DangerousPrototypes/Bus_Blaster/art/BusBlasterv3c600.jpg

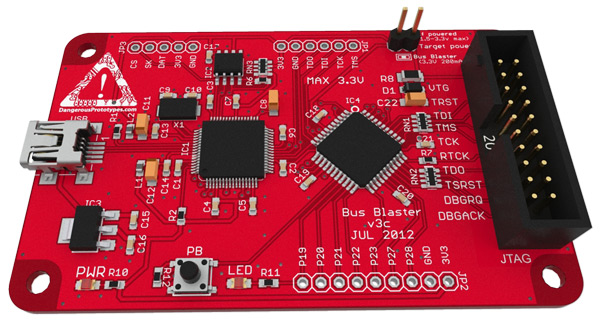
art/BusBlasterv3c600.jpg
