DangerousPrototypes/Bus_Blaster/art/bus-blaster-FTDI.jpg

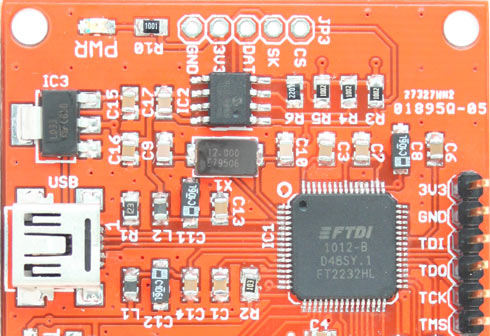
art/bus-blaster-FTDI.jpg
