DangerousPrototypes/Bus_Blaster/manufacturing_resources/v4.1/Test/testplan.txt

http://dangerousprototypes.com/docs/Bus_Blaster_v4_manufacturing_resources
