DangerousPrototypes/Bus_Blaster/hardware/BusBlaster-v2.5.htm

Part | Quantity | Value | Package
C1-C7,C13-C21 | 16 | 100nF | C603
C8 | 1 | 3.3uF | SMC_A
C9,C10 | 2 | 27pF | C603
C11,C12,C22 | 3 | 4.7uF | SMC_A
IC1 | 1 | FT2232H | LQFP64
IC2 | 1 | 93LC46B | SOIC8
IC3 | 1 | LD1117-3.3 | SOT223
IC4 | 1 | XC2C32A_VQ44_2 | VQ44
JP4 | 1 | 0.1” pin header | 1X02
JTAG | 1 | 2x10 shrouded header (0.1”) | PINHEAD_-_COPY_PINSHRD_PTH_2X10
L1,L2 | 2 | ferrite bead (800mA+) | FB603
LED | 1 | LED | LED-805
PB | 1 | Small push button | TACT_SWITCH_SMALL
PWR | 1 | LED | CHIPLED_0805
R1 | 1 | 12K 1% | R603
R2,R11 | 2 | 1K | R603
R3,R4,R5 | 4 | 10K | R603
R6 | 1 | 2.2K | R603
R10 | 1 | 1K | R603
USB | 1 | USB mini-B connector | CONN_USB_MINI-B
X1 | 1 | 12MHz crystal | 4X6@1
