DangerousPrototypes/Bus_Blaster/art/bb-v2-buffer.png

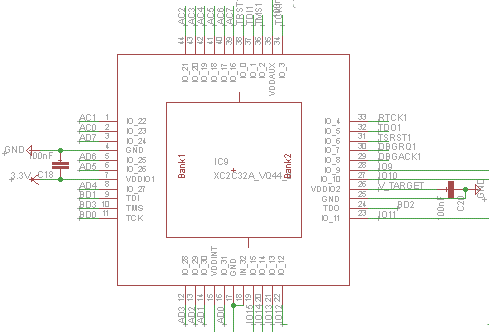
art/bb-v2-buffer.png
