DangerousPrototypes/Bus_Blaster/art/bus-blaster-buffer.jpg

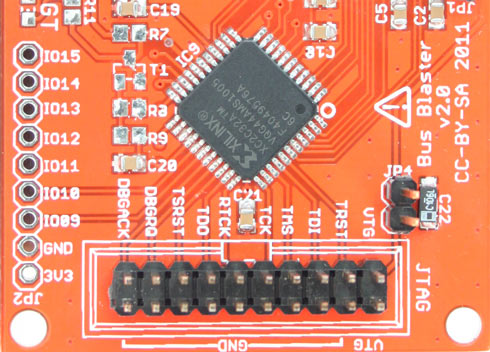
art/bus-blaster-buffer.jpg
