DangerousPrototypes/Bus_Blaster/art/bus-blaster-cover-shot-2-25.jpg

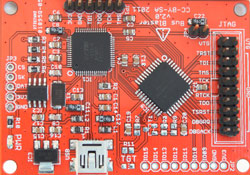
art/bus-blaster-cover-shot-2-25.jpg
