DangerousPrototypes/Bus_Blaster/art/bus-blaster-cover-shot.jpg

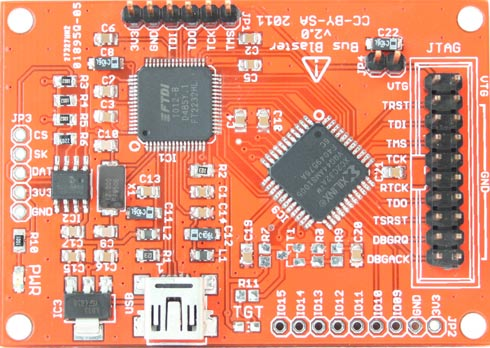
art/bus-blaster-cover-shot.jpg
