DangerousPrototypes/Bus_Blaster/art/bus-blaster-v2-block-diagra.png

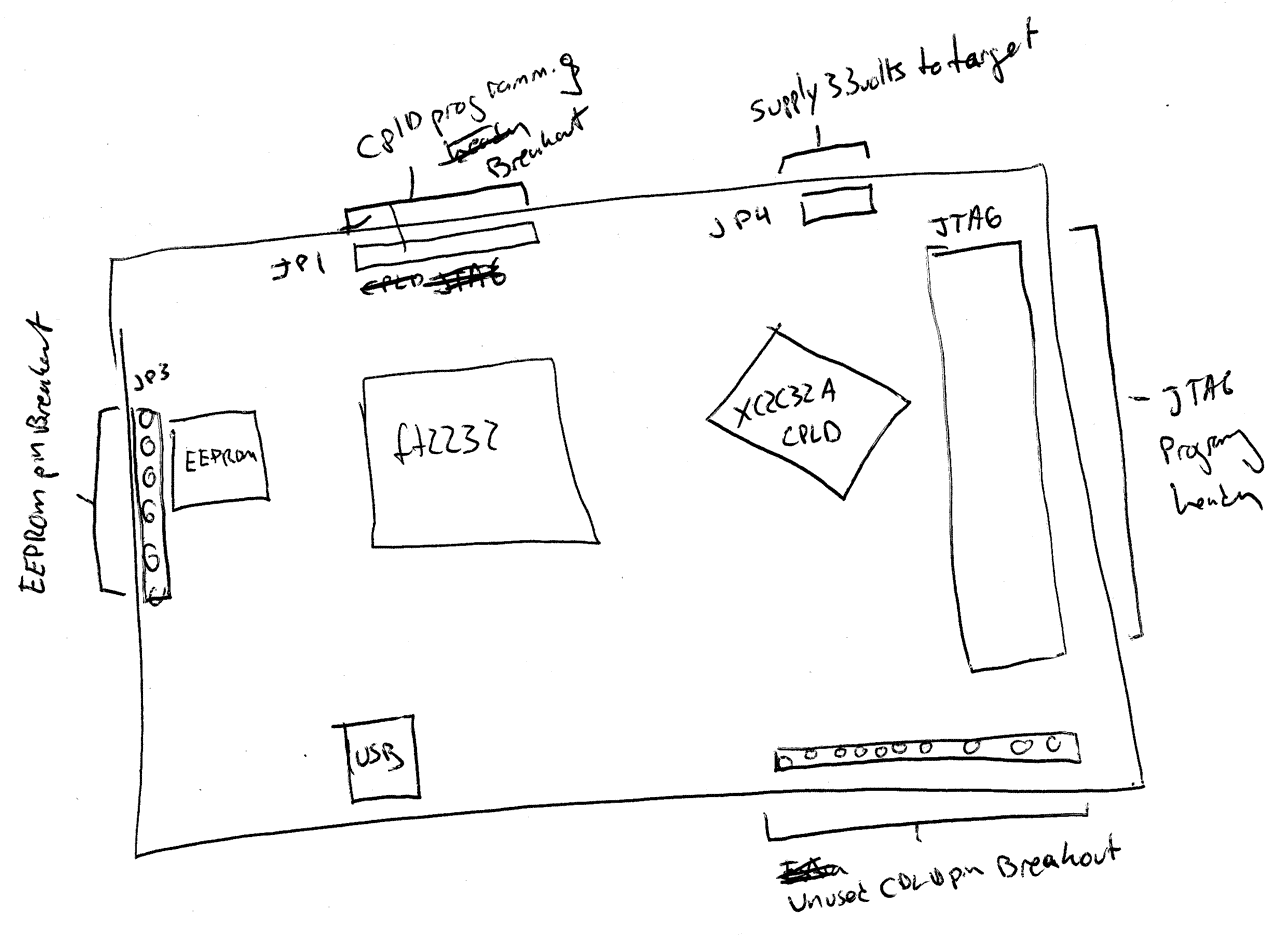
art/bus-blaster-v2-block-diagra.png
