DangerousPrototypes/Bus_Blaster/art/bus-blaster-v2-pcb.jpg

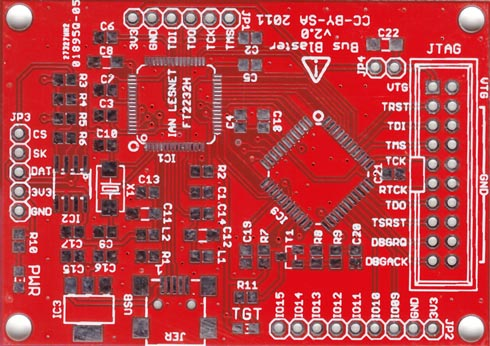
art/bus-blaster-v2-pcb.jpg
