DangerousPrototypes/Bus_Blaster/art/bus-blaster-v2-pinout.png

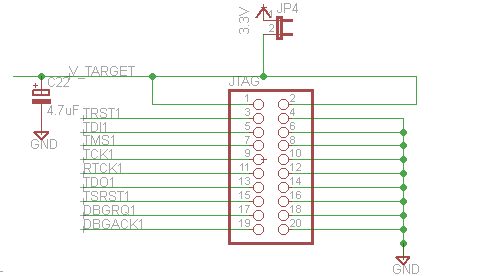
art/bus-blaster-v2-pinout.png
