DangerousPrototypes/Bus_Blaster/art/bus-blaster-v2.1-dev-update.jpg

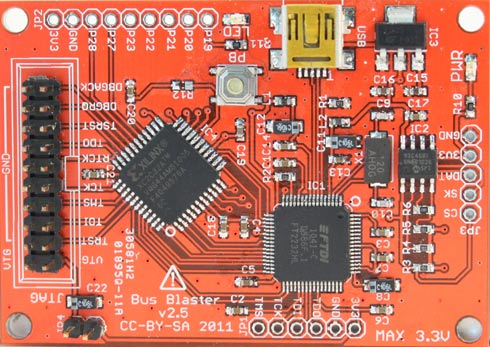
art/bus-blaster-v2.1-dev-update.jpg
