DangerousPrototypes/Bus_Blaster/art/BusBlaster3a.jpg

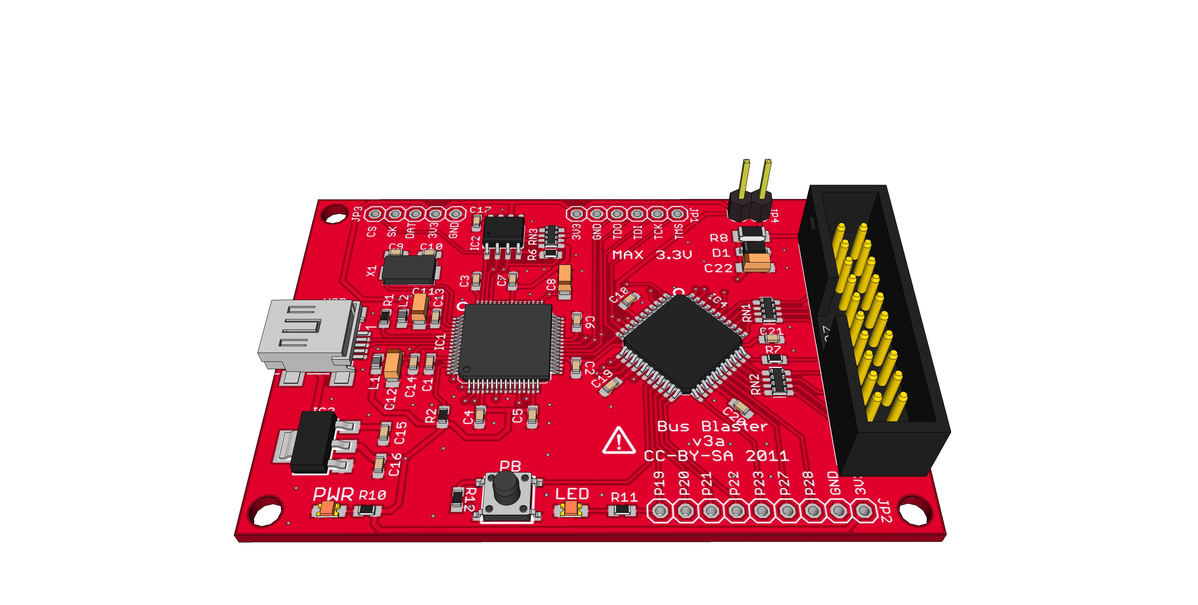
art/BusBlaster3a.jpg
