DangerousPrototypes/Bus_Blaster/art/Busblasterv2-490px.png

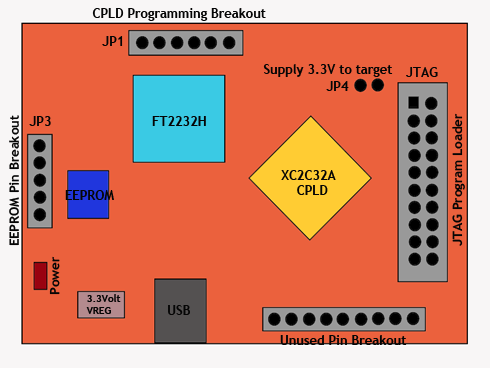
art/Busblasterv2-490px.png
