DangerousPrototypes/Bus_Blaster/art/Busblasterv2.png

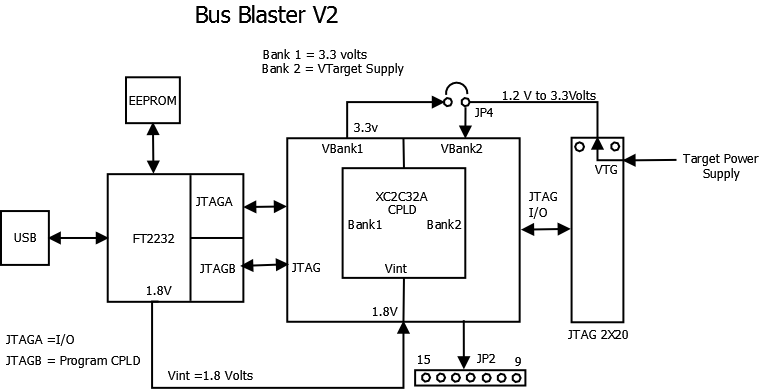
art/Busblasterv2.png
