DangerousPrototypes/Bus_Blaster/art/BusBlasterv2a1.png

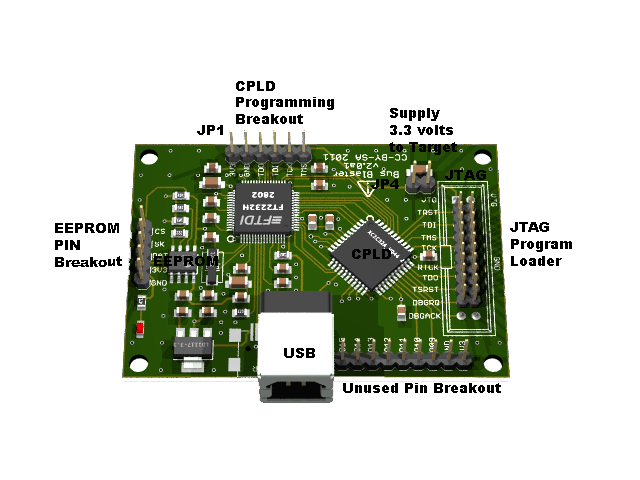
art/BusBlasterv2a1.png
