DangerousPrototypes/Bus_Blaster/art/BusBlasterv3c-orig.tif

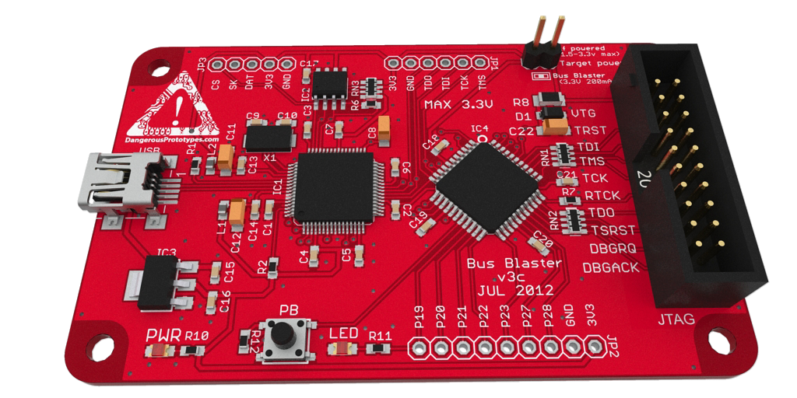
art/BusBlasterv3c-orig.tif
