DangerousPrototypes/Bus_Blaster/hardware/BusBlaster-v2.1a.brd.png

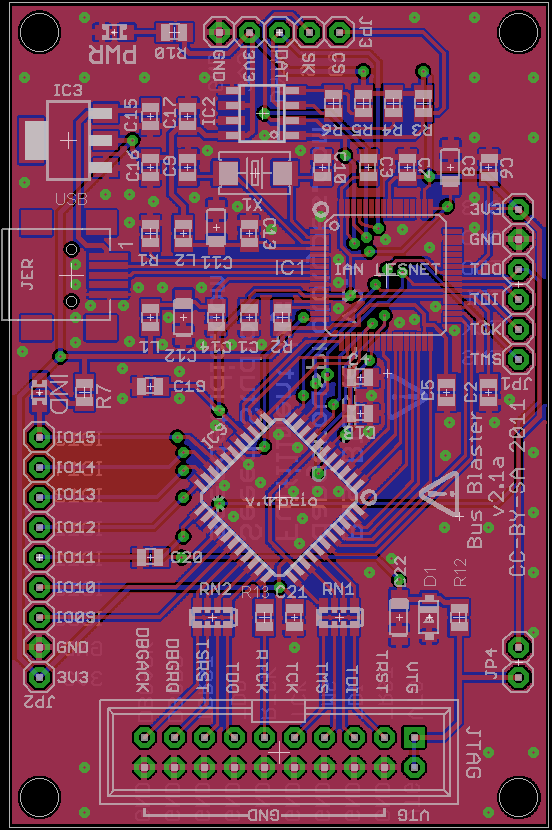
hardware/BusBlaster-v2.1a.brd.png
