DangerousPrototypes/Bus_Blaster/hardware/BusBlaster-v2.1a.sch.png

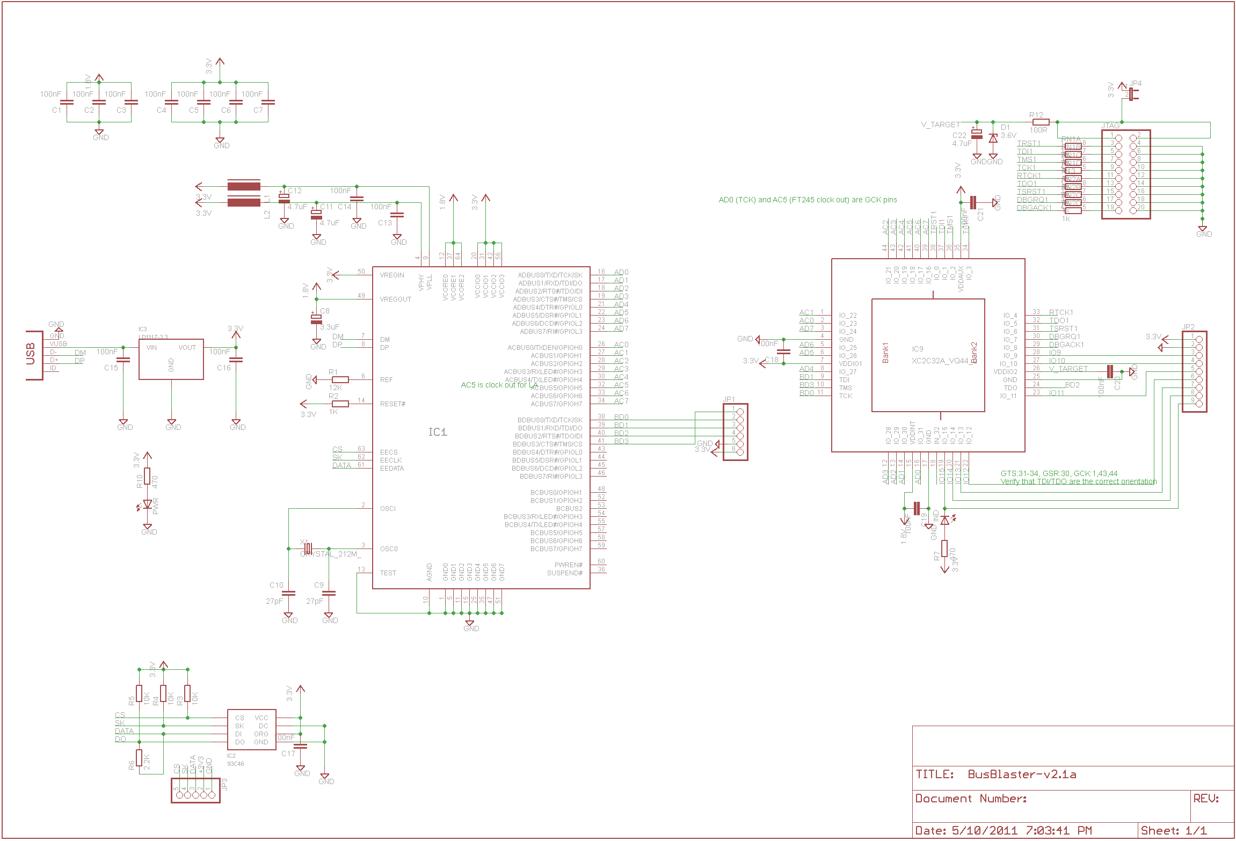
hardware/BusBlaster-v2.1a.sch.png
