DangerousPrototypes/Bus_Blaster/hardware/BusBlaster-v2.5.sch.png

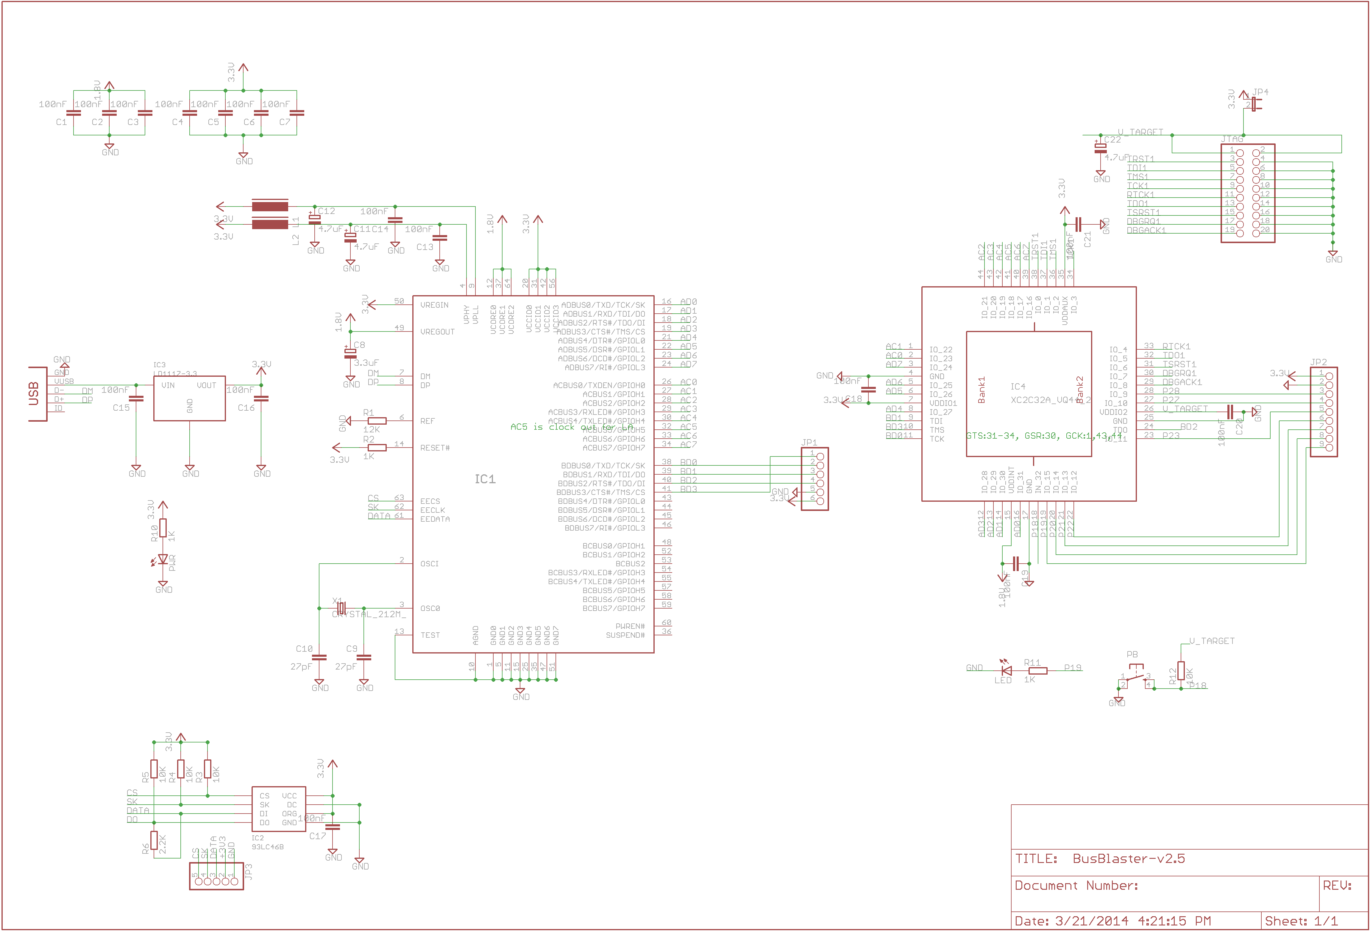
hardware/BusBlaster-v2.5.sch.png
