DangerousPrototypes/Bus_Blaster/hardware/BusBlaster-v2.6.brd.png

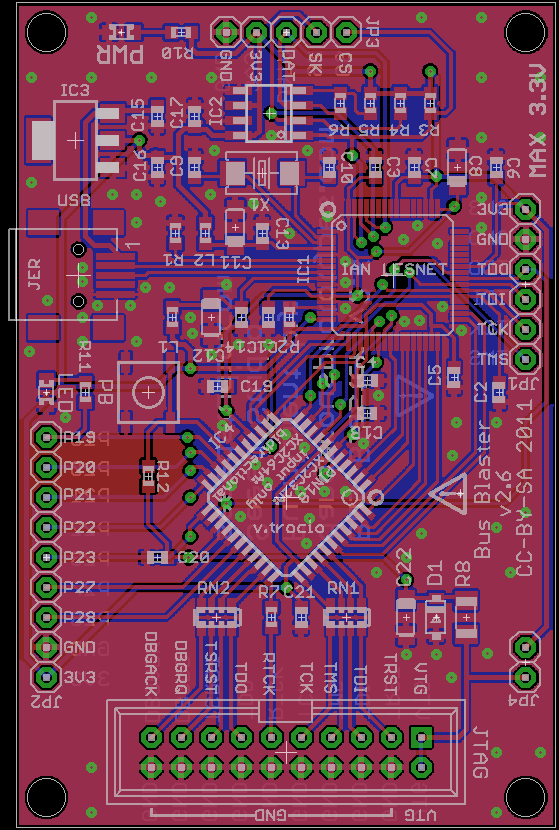
hardware/BusBlaster-v2.6.brd.png
