DangerousPrototypes/Bus_Blaster/hardware/BusBlaster-v3c.brd.png

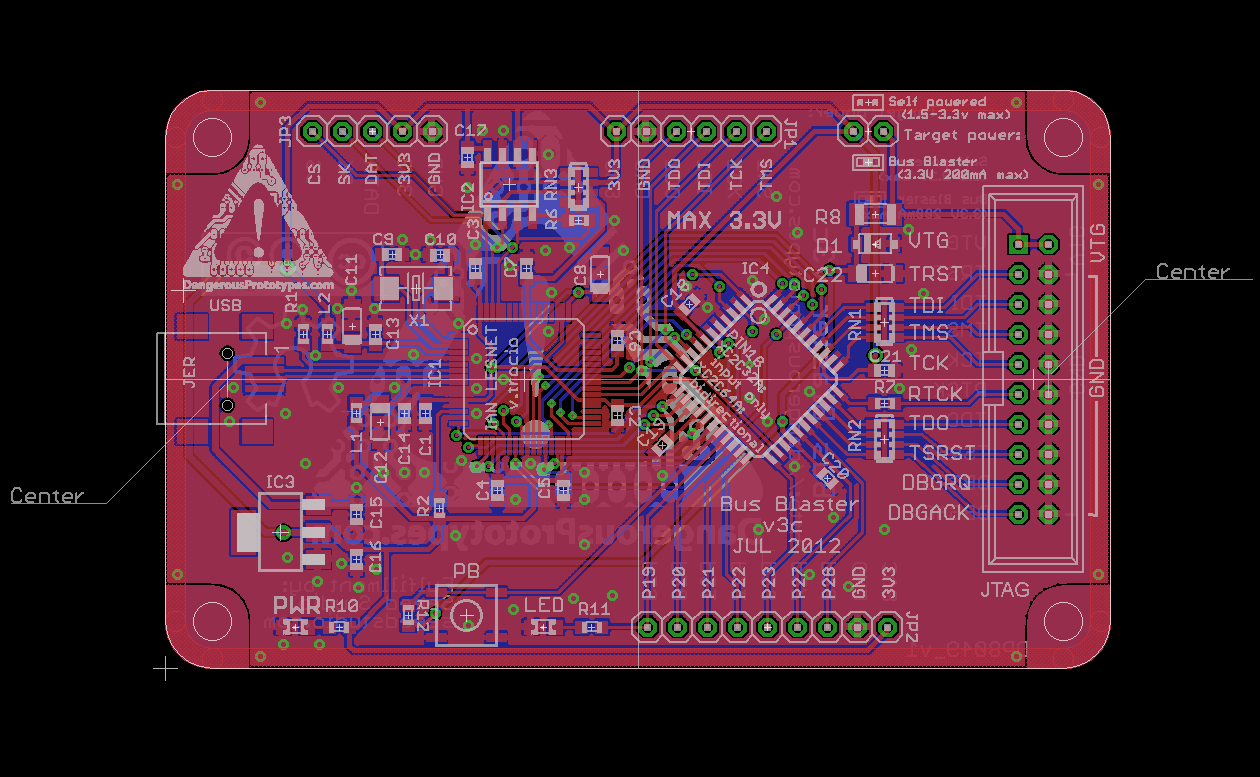
hardware/BusBlaster-v3c.brd.png
