DangerousPrototypes/Bus_Blaster/hardware/BusBlaster-v3c.sch.png

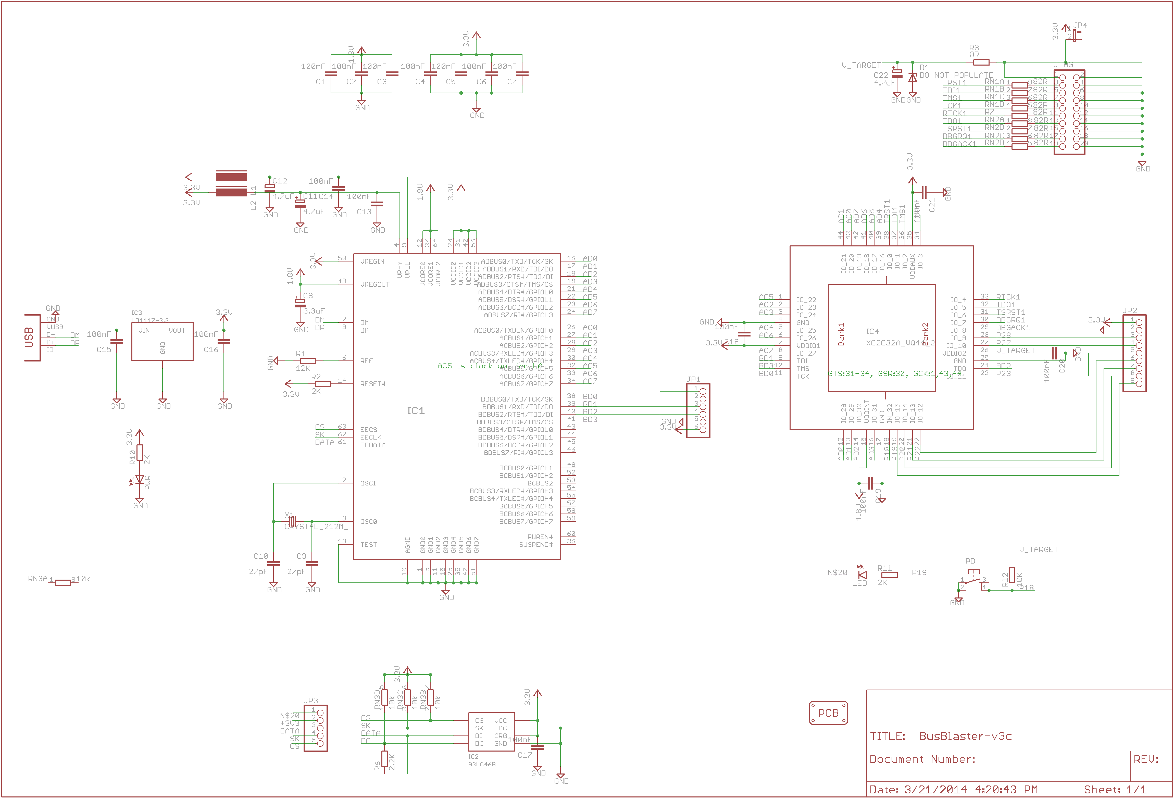
hardware/BusBlaster-v3c.sch.png
