DangerousPrototypes/Bus_Blaster/hardware/BusBlasterv4.1.brd.png

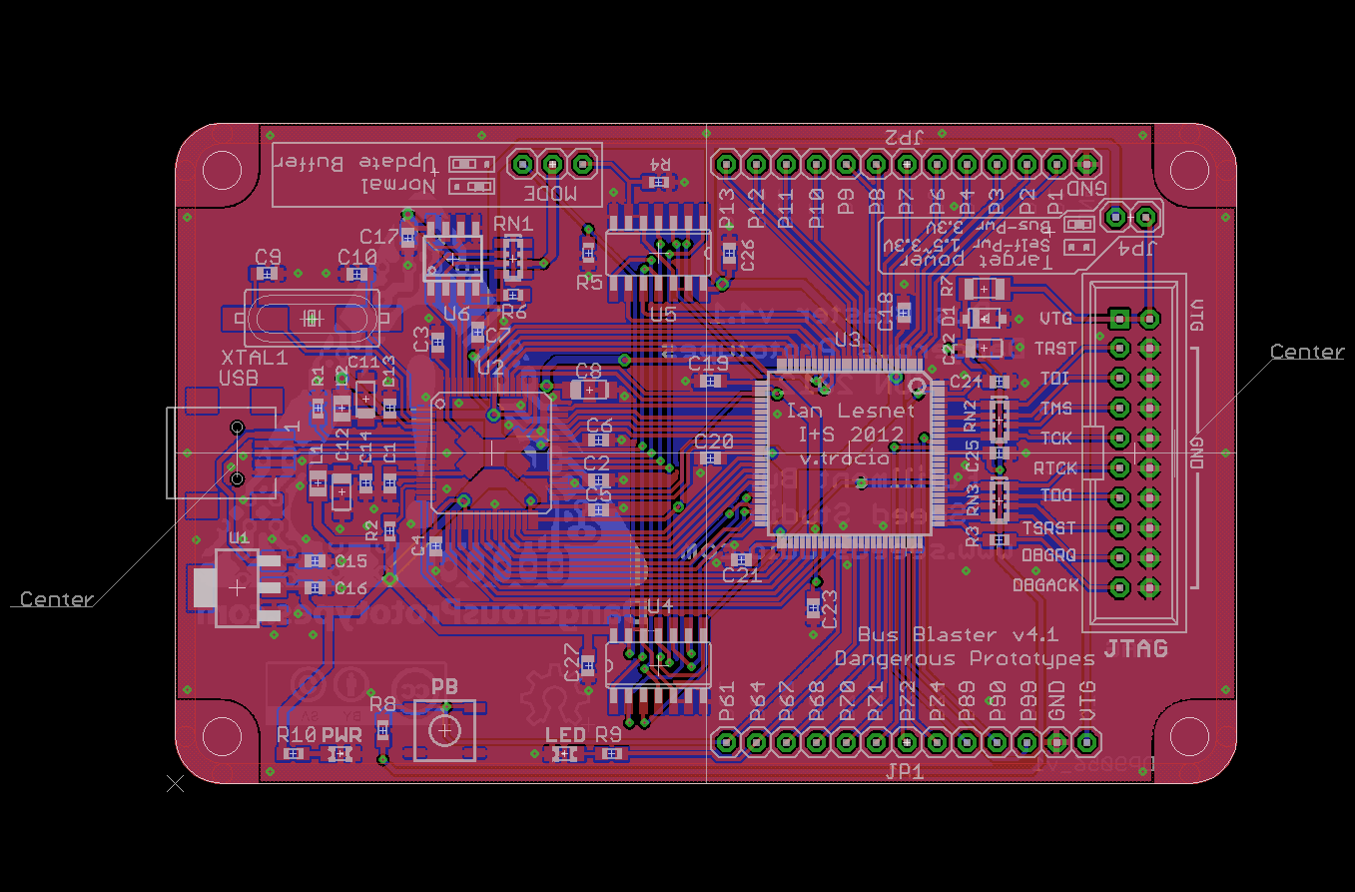
hardware/BusBlasterv4.1.brd.png
