DangerousPrototypes/Bus_Blaster/hardware/BusBlasterv4.1.sch.png

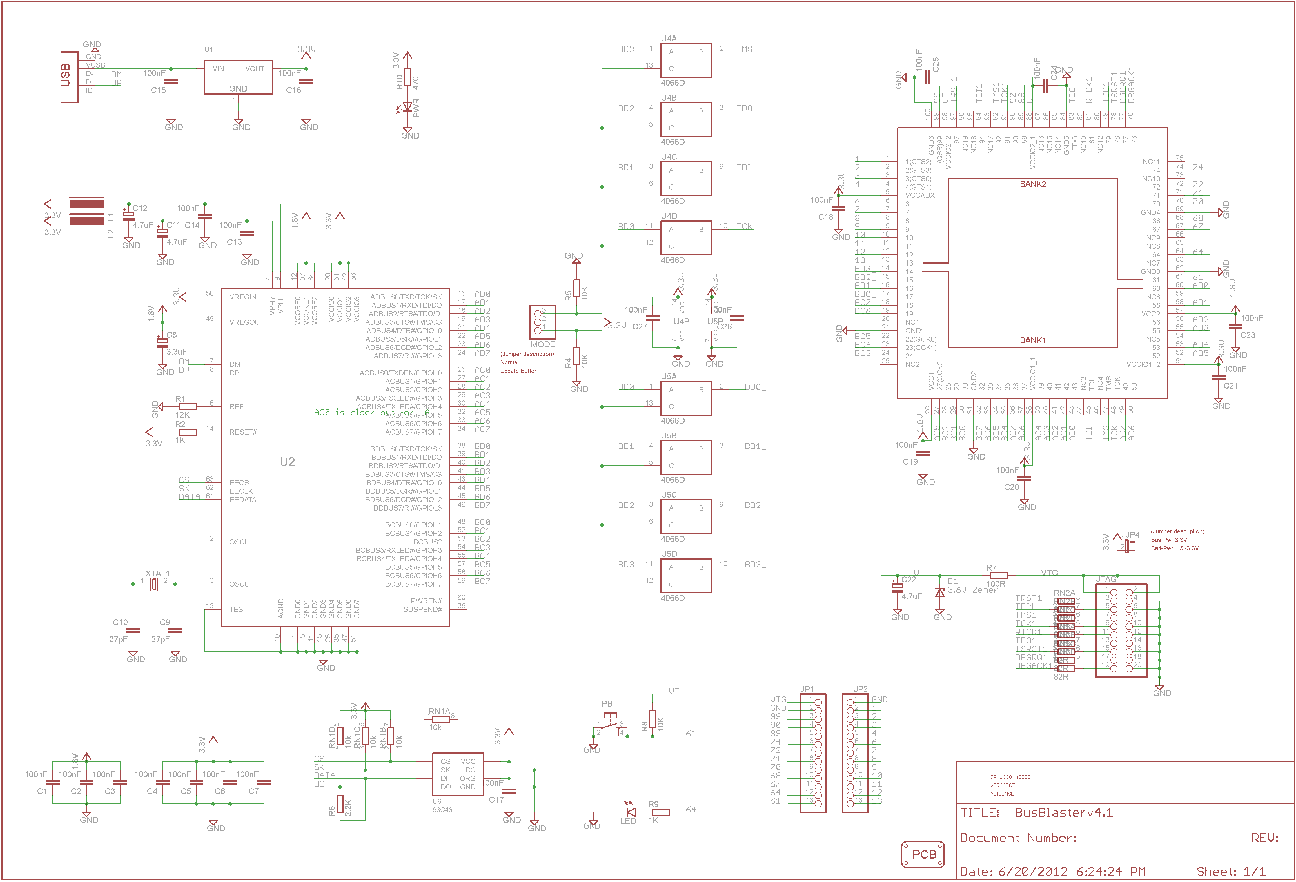
hardware/BusBlasterv4.1.sch.png
