DangerousPrototypes/Bus_Blaster/package/PCB_production/BusBlaster-v1.brd.png

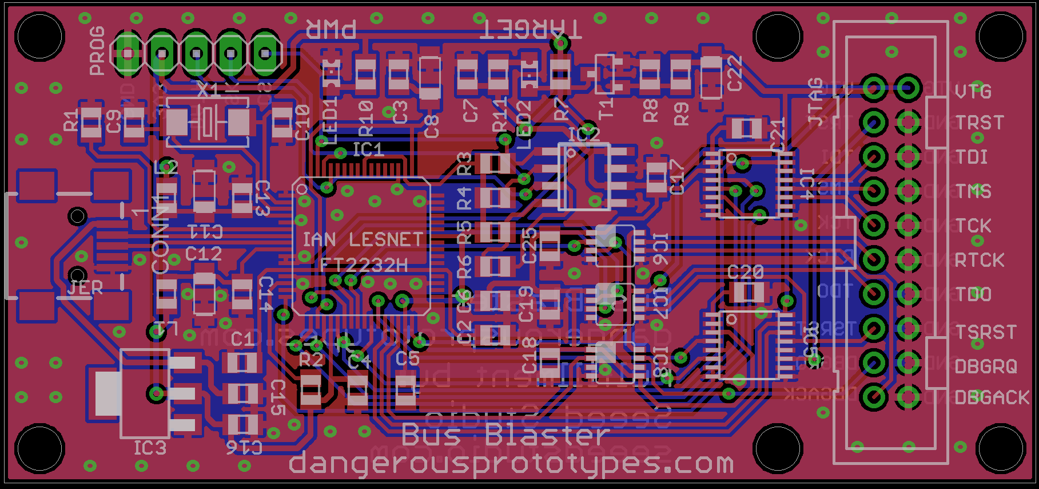
package/PCB_production/BusBlaster-v1.brd.png
