DangerousPrototypes/Bus_Blaster/package/PCB_production/BusBlaster-v1.sch.png

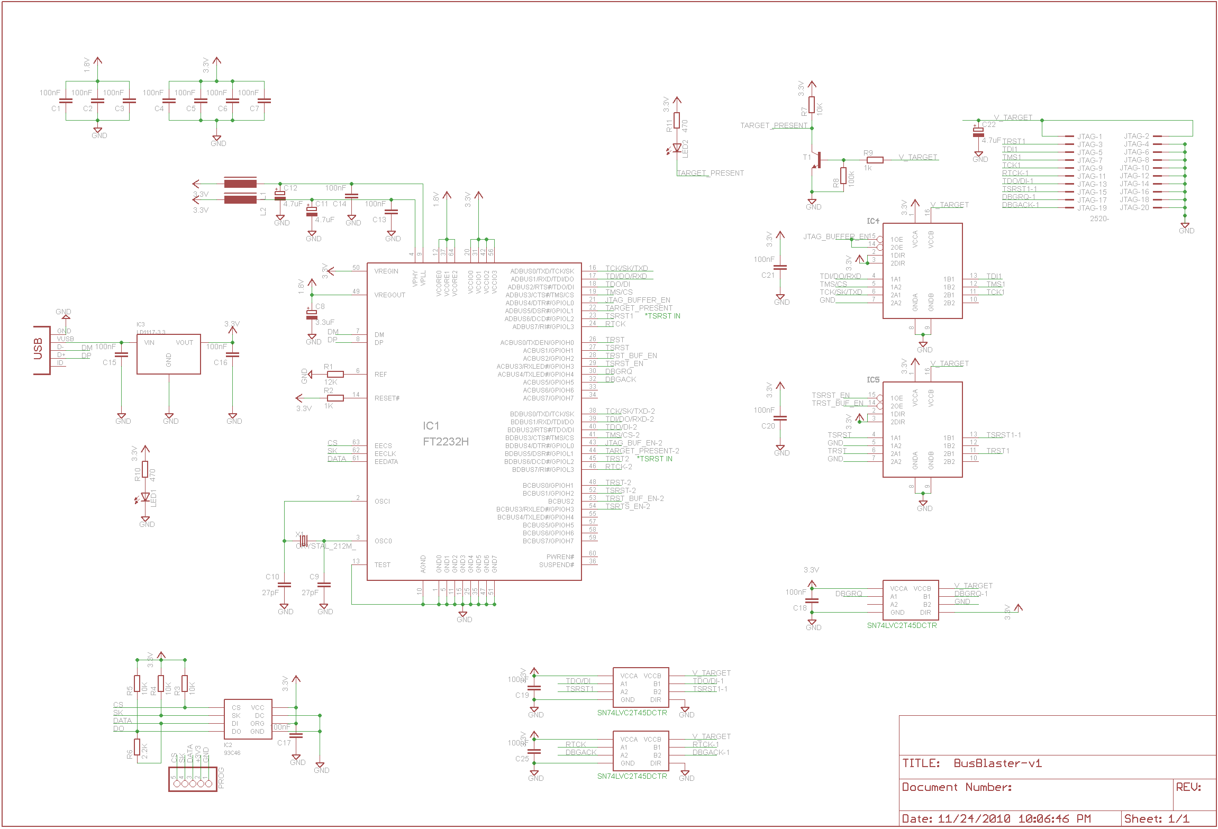
package/PCB_production/BusBlaster-v1.sch.png
