DangerousPrototypes/Bus_Blaster/package/PCB_production/BusBlaster-v2.0a1.brd.png

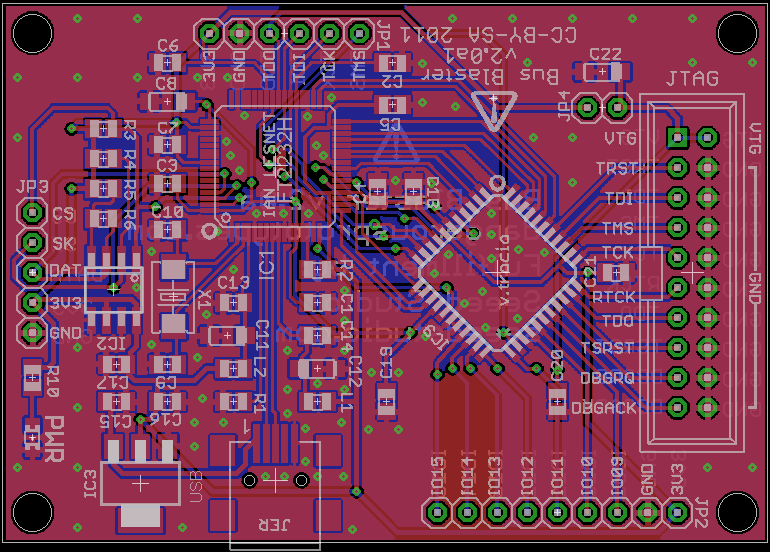
package/PCB_production/BusBlaster-v2.0a1.brd.png
