DangerousPrototypes/Bus_Blaster/hardware/BusBlaster-v4.1a-partslist.xls

Electronic Engineering BOM List v1.0
Product Name Bus Blaster
Version： v4.1
Issue Date： July 19, 2012
Item No. (序号) | Catalog (分类） | Reference Des (上件位置) | Part_Description (规格描述) | Part_Value （元件值） | Part_Package （元件封装） | Qty (用量) | Manufacturers Name (使用厂牌名称) | Manufacturers Part No. (使用厂牌型号) | Distributors Name （供应商名称） | Distributors Part No. (供貨商型号) | Unit Price （单价） | Price Break To Use （价格分段的购买量） | Stock Status （库存状态） | Notes/Remark （备注）
1 | Resister | R2,R9 | SMD Resistor | 1K | R603 | 2
2 | Resister | R6 | SMD Resistor | 2.2K | R603 | 1
3 | Resister | R4,R5 | SMD Resistor | 10K | R603 | 2
4 | Resister | R1 | SMD Resistor | 12K | R603 | 1
5 | Resister | R3 | SMD Resistor | 82R | R603 | 1
6 | Resister | R7 | SMD Resistor | 0R | R603 | 1
7 | Resister | R10 | SMD Resistor | 470R | R603 | 1
8 | Resister | RN1 | SMD 4 Resistor Array | 10K | R603 | 1
9 | Resister | RN2,RN3 | SMD 4 Resistor Array | 82R | R603 | 2
10 | Capacitor | C8 | SMD Tantalum Capacitor | 3.3uF/ 3V or higher | SMC-A | 1
11 | Capacitor | C11,C12,C22 | SMD Tantalum Capacitor | 4.7uF / 6.3V or higher | SMC-A | 3
12 | Capacitor | C9,C10 | SMD MLCC Capacitor | 27pF / 50v or higher | C603 | 2
13 | Capacitor | C1, C2, C3, C4, C5, C6, C7, C13, C14, C15, C16, C17, C18, C19, C20, C21, C23, C24, C25, C26, C27 | SMD MLCC Capacitor | 0.1uF / 50v or higher | C603 | 21
14 | Diode | D1 | **DO NOT POPULATE** | - | -
15 | OTHER | L1, L2 | SMD Ferrite Bead 330R-1000mA | 1.7A 330R or equivalent | L603 | 2
16 | OTHER | LED | SMD LED Yellow |  | LED0805 | 1
17 | OTHER | PWR | SMD LED Red |  | LED0805 | 1
18 | OTHER | XTAL1 | SMD Crystal | 12Mhz | HC-49US | 1
19 | IC | U1 | 800mA LDO Voltage regulator | LD1117S33TR | SOT-223 | 1
20 | IC | U2 | FTDI Dual USB to UART/FIFO | FT2232HL | LQFP-64 | 1 | http://ph.mouser.com/Search/ProductDetail.aspx?R=FT2232HLvirtualkey62130000virtualkey895-FT2232HL
21 | IC | U3 | 64macrocells CPLD | XC2C64A-7VQG100C | VQ-100 | 1 | http://www.digikey.com/scripts/DkSearch/dksus.dll?vendor=0&keywords=XC2C64A-7VQG100C+
22 | IC | U4, U5 | Quad Bilateral switch | CD4066BCM | SOIC-14 | 2 | http://ph.mouser.com/Search/ProductDetail.aspx?R=CD4066BCMvirtualkey51210000virtualkey512-CD4066BCM
23 | IC | U6 | 64x16 SPI EEPROM | 93LC46B-I/SN | SOIC-8 | 1 | http://ph.mouser.com/ProductDetail/Microchip-Technology/93LC46B-I-SN/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
24 | OTHER | PB | SMD 5.2mm Tactile switch |  |  | 1 | http://ph.mouser.com/Search/ProductDetail.aspx?R=SKQGADE010virtualkey68800000virtualkey688-SKQGAD
25 | Connector | USB | SMD 5 Pin USB Mini-B Female |  |  | 1 | http://ph.mouser.com/ProductDetail/Kobiconn/154-15320-E/
26 | OTHER | - | 2 pins (1 x 02) 0.1" pitch Jumper |  |  | 2 | Jumper for MODE and JP4
27 | Connector | JP4 | 2 pins (1 x 02) 0.1" pitch Straight Male Header |  |  | 1
28 | Connector | MODE | 3 pins (1 x 03) 0.1" pitch Straight Male Header |  |  | 1
29 | Connector | JTAG | 20 pins (2 x 10) 0.1" pitch Straight Male Header |  |  | 1
1. Recommended Distributors: Digi-Key, Mouser, Avnet Express, Farnell.
2. Catalog: Capacitor,Resister,Diode,Connector,Transistor,IC,PROTECTOR CATEGORY,OTHER
3. Required Fields: Item No, Reference Des, Qty, Catalog, Part_Value, Part_Package, Part_Description
Optional Fields: Manufacturers Name, Manufacturers Part No, Distributors Name, Distributors Part No, Unit Cost, Price break to use, Stock Status，Notes/Remark
 |  |  |  |  |  |  |  |  | by
