DangerousPrototypes/Bus_Blaster/hardware/BusBlaster-v3b-partlist.xls

Electronic Engineering BOM List v1.0
Product Name： Bus Blaster
Version： V3b
Issue Date：May 2, 2012
Item No. (序号) | Catalog (分类） | Reference Des (上件位置) | Part_Description (规格描述) | Part_Value （元件值） | Part_Package （元件封装） | Qty (用量) | Manufacturers Name (使用厂牌名称) | Manufacturers Part No. (使用厂牌型号) | Distributors Name （供应商名称） | Distributors Part No. (供貨商型号) | Unit Price （单价） | Price Break To Use （价格分段的购买量） | Stock Status （库存状态） | Notes/Remark （备注）
1 | Capacitor | C1-C7,C13-C21 | Capacitor | 0.1uF | C603 | 16
2 | Capacitor | C8 | Capacitor Tantalum | 3.3uF | SMC A | 1
3 | Capacitor | C9,C10 | Capacitor | 27pF | C603 | 2
4 | Capacitor | C11,C12,C22 | Capactor Tantalum | 4.7uF | SMC A | 3
5 | Diode | D1 | Zener Diode 3.6V | 3.6V | SOD-123 | 1 | added
6 | IC | IC1 | FT2232HL |  | LQFP64 | 1 |  | http://www2.mouser.com/ProductDetail/FTDI/FT2232HL-REEL/
7 | IC | IC2 | 93C46BT-I/SN |  | SOIC8 | 1 |  | http://www2.mouser.com/ProductDetail/Microchip-Technology/93C46BT-I-SN/?qs=e4wS3D8CKP6pMdi9cYa8KVxytou5sW7y
8 | IC | IC3 | LDO 3.3V 800mA+ Voltage regulator (LD1117-3.3 or similar) |  | SOT-223 | 1
9 | IC | IC4 | XC2C32A-6VQG44C |  | VQ44 | 1 |  | http://search.digikey.com/us/en/products/XC2C32A-6VQG44C/122-1404-ND/949455
10 | Connector | JP4 | 0.1'' Male Pinheader |  | M1x2 | 1
11 | Connector | JTAG | 0.1'' Male Shrouded Pinheader |  | MS2x10 | 1
12 | OTHER | L1,L2 | 500mA+ Ferrite bead |  | FB603 | 2
13 | OTHER | LED, PWR | LED YELLOW |  | 805 | 2 | changed to yellow
14 | OTHER | PB | SMD 5.2mm Low Profile Tactile switch |  |  | 1 |  | http://search.digikey.com/scripts/DkSearch/dksus.dll?WT.z_header=search_go&lang=en&site=us&x=0&y=0
15 | Resister | R1 | Resistor | 12K 1% | R603 | 1
16 | Resister | R6 | Resistor | 2.2K | R603 | 1
17 | Resister | R7 | Resistor | 27R | R603 | 1 | added
18 | Resister | R8 | Resistor | 100R | R1206 | 1 | added
19 | Resister | R2,R10,R11 | Resistor | 2K | R603 | 3 | added
20 | Resister | R12 | Resistor | 10k | R603 | 1 | added
21 | OTHER | RN1, RN2 | Resistor Array (4) | 27R | RN8P-4R-CRA06S | 2 | added
22 | OTHER | RN3 | Resistor Array (4) | 10K | RN8P-4R-CRA06S | 1 | added
23 | Connector | USB | SMD USB Mini-b Female |  |  | 1
24 | OTHER | X1 | 12MHz Crystal |  | 4mmx6mm | 1
1. Recommended Distributors: Digi-Key, Mouser, Avnet Express, Farnell.
2. Catalog: Capacitor,Resister,Diode,Connector,Transistor,IC,PROTECTOR CATEGORY,OTHER
3. Required Fields: Item No, Reference Des, Qty, Catalog, Part_Value, Part_Package, Part_Description
Optional Fields: Manufacturers Name, Manufacturers Part No, Distributors Name, Distributors Part No, Unit Cost, Price break to use, Stock Status，Notes/Remark
 |  |  |  |  |  |  |  |  | by Heidi Luo
 |  |  |  |  |  |  |  |  | 21/4/2011
