DangerousPrototypes/Bus_Blaster/package/PCB_production/BusBlaster-v2a1-partlist.xls

Part | Quantity | Value | Package
C1-C7,C13-C21 | 16 | 100nF | C805
C8 | 1 | 3.3uF | SMC_A
C9,C10 | 2 | 27pF | C805
C11,C12,C22 | 3 | 4.7uF | SMC_A
IC1 | 1 | FT2232H | LQFP64
IC2 | 1 | 93LC46B | SOIC8
IC3 | 1 | LD1117-3.3 | SOT223
IC9 | 1 | XC2C32A_VQ44_2 | VQ44
JP4 | 1 | 0.1” pin header | 1X02
JTAG | 1 | 2x10 shrouded header (0.1”) | PINHEAD_-_COPY_PINSHRD_PTH_2X10
L1,L2 | 2 | ferrite bead (800mA+) | FB805
PWR | 2 | LED | CHIPLED_0805
R1 | 1 | 12K 1% | R805
R2 | 2 | 1K | R805
R3,R4,R5 | 4 | 10K | R805
R6 | 1 | 2.2K | R805
R10 | 2 | 1K | R805
USB | 1 | USB mini-B connector | CONN_USB_MINI-B
X1 | 1 | 12MHz crystal | 4X6
