DangerousPrototypes/Bus_Blaster/manufacturing_resources/v3c/PCB/BusBlaster-v3c.brd.png

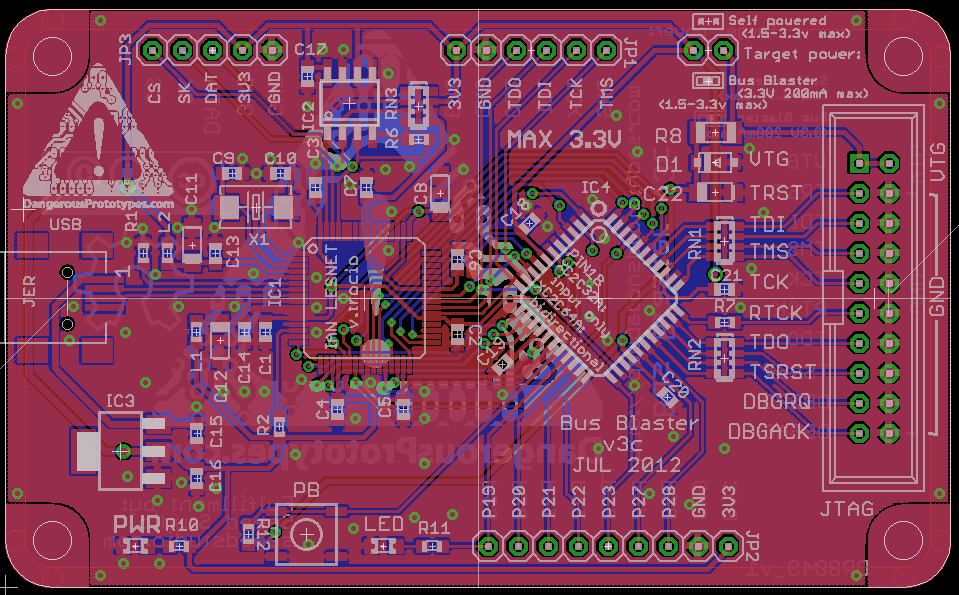
manufacturing_resources/v3c/PCB/BusBlaster-v3c.brd.png
