DangerousPrototypes/Bus_Blaster/manufacturing_resources/v4.1/PCB/BusBlaster-v4.1a.brd.png

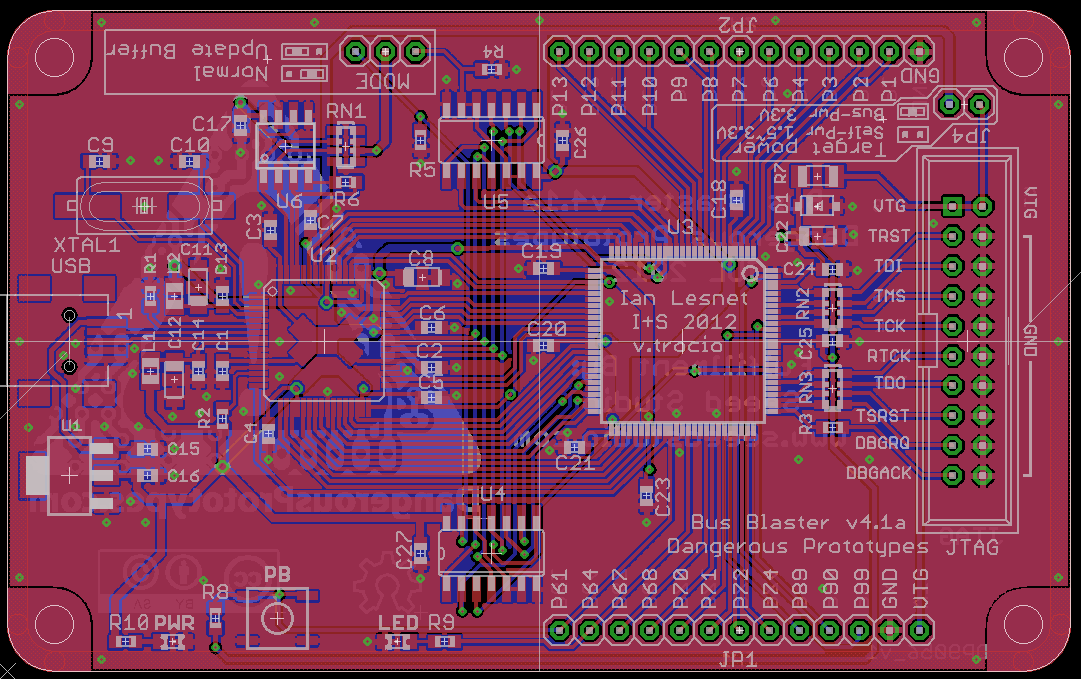
manufacturing_resources/v4.1/PCB/BusBlaster-v4.1a.brd.png
