DangerousPrototypes/Bus_Blaster/buffer_logic/JTAGkey_test/jtagkey_summary.html

jtagkey Project Status
Project File: | BBv4-JTAGkey_Test.xise | Parser Errors:
Module Name: | jtagkey | Implementation State: | New
Target Device: | xc2c64a-5VQ100 | Errors:
Product Version: | ISE 13.4 | Warnings:
Design Goal: | Balanced | Routing Results:
Design Strategy: | Xilinx Default (unlocked) | Timing Constraints:
Environment: | | Final Timing Score:

Detailed Reports | | | | | | [-]
Report Name | Status | Generated | Errors | Warnings | Infos
Synthesis Report
Translation Report
CPLD Fitter Report (Text)
Power Report

Secondary Reports | | | [-]
Report Name | Status | Generated
Post-Fit Simulation Model Report

Date Generated: 10/18/2012 - 12:56:38
