DangerousPrototypes/Bus_Blaster/manufacturing_resources/v2.0a1/self_test/selftest_summary.html

selftest Project Status
Project File: | selftest.xise | Parser Errors:
Module Name: | selftest | Implementation State: | New
Target Device: | xc2c32a-4VQ44 | Errors:
Product Version: | ISE 12.1 | Warnings:
Design Goal: | Balanced | Routing Results:
Design Strategy: | Xilinx Default (unlocked) | Timing Constraints:
Environment: | | Final Timing Score:

Detailed Reports | | | | | | [-]
Report Name | Status | Generated | Errors | Warnings | Infos
Synthesis Report
Translation Report
CPLD Fitter Report (Text)
Power Report

Secondary Reports | | | [-]
Report Name | Status | Generated
ISIM Simulator Log | Out of Date | Tue Apr 26 17:40:41 2011
Post-Fit Simulation Model Report

Date Generated: 04/26/2011 - 18:27:57
