DangerousPrototypes/Bus_Blaster/(commit log)

2011-04-13 bus blaster redo
    [BBv2JTAGKEY.sch, BBv2KTLINK.sch, BusBlaster-v1-partlist.xls, BusBlaster-v1.brd, BusBlaster-v1.sch, BusBlaster-v2a1-partlist.xls, BusBlaster-v2a1.brd, BusBlaster-v2a1.sch]
2011-04-13 schematic tutorial 1 final
2011-04-13 schematic 2 tutorial
2011-04-13 xc2c64a schematic Tutorials
2011-04-13 moved RC RGB pumpkin to IR Toy folder (uses IR Toy firmware)
2011-04-13 ir toy v12 dump - fixed LED test for v2
2011-04-13 fixed/merge and move busblaster from bus_blaster dir
    [BBv2JTAGKEY.sch, BBv2KTLINK.sch, KTlink.sch]
2011-04-13 added png files and bom (htm)
2011-04-14 Updates to Verilog tutorials from here: http://dangerousprototypes.com/2011/04/13/cpld-development-board-package-v1-1/#comment-10004
2011-04-14 pcb schematic images
2011-04-14 cpld dev board sales pages
2011-04-14 added copying.txt, move some files to parent dir, created new package dir for each that is missing
    [BBv2JTAGKEY.sch]
2011-04-15 gerber files
2011-04-15 board and schematic
    [BusBlasterv2.5.brd, BusBlasterv2.5.sch]
2011-04-15 gerbers pcb schematics
2011-04-15 pcb schematics images
2011-04-15 gerbers pcb schematic
2011-04-15 manufacturing resources firmware_dump gerbers sales page test_plan
2011-04-15 gerbers/BusPirate-v3.5-SOIC gerber
2011-04-15 pcb schematic
2011-04-18 board schematic
2011-04-18 board schematic images
2011-04-18 gerbers brd schematic
2011-04-18 Stalled projects
2011-04-18 board achematic
2011-04-18 Super probe commit cleanup
2011-04-18 superprobe bom
2011-04-18 superprobe part and schematic synced
2011-04-18 gerbers board schematic images
2011-04-18 gerbers board schematics images
2011-04-18 left handed super probe
2011-04-20 ADD license to XTIDE: Board and schematic CC-BY-SA-3.0, Xtidecpld1: CC-0
2011-04-20 updated copying.txt board and sch cc-by-sa.3.0,urjtag gpl3.0, manufacturing is cc-0
2011-04-26 board schematic partlist images
2011-04-29 board schematic gerbers
2011-04-29 updated board shematic gerbers
2011-04-29 updated board schematic gerbers
2011-05-01 Added Device: LC4032V CPLD in TQFP44 package
2011-05-03 LCD Backpack v1a with cuttable trace on contrast adjust solder jumper.
2011-05-04 Added device: EPM3064A CPLD in TQFP44 package
2011-05-08 Updates: swap location of 2 USB connector and power supply section to make the USB connection much shorter and closer main chip. Disconnect USB D- and microSD's DATA2 line, I this this is mis-connect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
2011-05-10 Bus Blaster v2.1a files commit.
    [BusBlaster-v2.1a.brd, BusBlaster-v2.1a.sch]
2011-05-16 -routed analog divider resistors -clean-up eeprom ISP header / clock test point -mounting holes connected to ground -schematic clean-up
2011-05-22 update: added I/O header for unused pins, added mounting holes, added LED, added labels for IO and ICSP and increment version to 1.1
2011-05-22 added schematic picture for v1a
2011-05-22 added BusBlaster-v2.6 added series resistor network on JTAG port added regulator for target supply board size expand a bit longer
    [BusBlasterv2.6.brd, BusBlasterv2.6.sch]
2011-05-27 Dangerous DSO minor updates and gerbers
2011-05-27 Bus Blaster v25 and v26 file rename
    [BusBlaster-v2.5.brd, BusBlaster-v2.5.sch, BusBlaster-v2.6.brd, BusBlaster-v2.6.sch]
2011-05-27 Bus Blaster v2.6
    [BusBlaster-v2.6.brd, BusBlaster-v2.6.sch]
2011-05-27 Bus Blaster v2.6 isolation to 12
    [BusBlaster-v2.6.brd]
2011-05-27 XC9572XL v1a. Moved pin 8 label on silk.
2011-05-27 Added user contrib single sided IR TOy v2 in gschem and PCB. From: http://dangerousprototypes.com/forum/viewtopic.php?f=29&t=2331&view=unread#p22269
2011-05-29 updated license files: cc-by-sa 3.0 for pcbs, firmware, cc-0 for support apps
2011-06-03 updated license to cc-by-sa-3.0 for boards
2011-06-05 USB IR Toy Shield v2.0 revisions -Added constant current diodes -Removed 2 IR LEDs, one LED left for IR TX -All R, C and Diodes change to through hole, Used R -added bottom GND fill -month revise to 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
2011-06-09 update of license to cc-by-sa-3.0 for boards
2011-06-09 update license to cc-by-sa-3.0 for boards cc-0 for supporting utilities
2011-06-16 v1.1.1 --changes was made to ensure to follow the coding guidelines required in this link: http://area51.phpbb.com/docs/30x/coding-guidelines.html#codelayout
    -- add spaces between tokens
    -- Used tabs between '=>' symbols
    -- added brackets when needed especially on one liner ifs,
    -- Change title to Disable links for new users
2011-06-22 How to tweet printing works
2011-06-26 Added vregs: LD1117-5.0 and 78XX series in DPAK and D2PAK footprint
2011-07-06 bus pirate demo board crystal speed update
2011-07-10 moved hardcoded strings to board.php
2011-07-14 Bus blaster v2 self test buffer
    [BusBlasterv2a1.brd, BusBlasterv2a1.sch, BusBlasterv2a1_Partlist.xls]
2011-07-15 Added devices: 0805 PTC fuse and the 3362P trimmer
2011-07-15 Dangerous Prototypes Android Accessory Development kit
2011-07-15 Dangerous Prototypes' Android Accessory Development Kit
2011-07-21 Added device: SMD DC barrel jack
2011-07-24 Added device: USB Type-A SMD
2011-07-25 Bus Pirate demo board for quote
2011-07-26 Added variant with flipped shrouded case for the Shrouded 2x5 PTH header
2011-07-26 updated BusPirate-v3.5b, flipped shrouded header case, header notch is now facing inside
2011-08-11 Screenshot to show the disconnected traces on the PCB.
2011-08-15 mobile theme switcher update for playstation portable
2011-08-21 revise CON-USB-A-MALE: added slotted holes
2011-08-22 Final Linux web board
2011-08-24 Bus Pirate v3.5a SOIC for DIY PCBs
2011-08-29 open source USB stack echo demo interrupts, double buffer output
2011-08-29 Changes on v1b 3.3V routed additional address control lines, change pull up resistor to network resistor type, shorten the board edge to fit on the ISA bracket, reside configuration text to fit.
2011-08-30 Fixed interrupts with bootloader on BPv4
2011-08-31 Device can go faster fix, LED and self-test updates from Tayken.
2011-09-01 Bus Blaster v2.5 updates
    [BusBlaster-v2.5-partlist.xls, BusBlaster-v2.5.brd, BusBlaster-v2.5.sch]
2011-09-01 Bus Blaster v2.5 NPI
    [BusBlaster-v2.5-partlist.xls, BusBlaster-v2.5.brd, BusBlaster-v2.5.sch]
2011-09-04 Changes on v1b 5V Copied updates on v1b 3.3V and removed 3.3 VREG.
2011-09-04 revise VQ44 package, added pin 1 marker
2011-09-04 on 3.3V v1b -put a solder jumper for the CPLD voltage select, default is with 3.3V VREG and the jumper is open, there should be no VREG when in 5V and the jumper should be shorted out. -HDD activity 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
    on 5V v1b
    -copy the 3.3V v1b board and removed the VREG (minor changes)
2011-09-04 New solder jumper in eagle library and BPv4 LCD adapters.
2011-09-05 started connection on 100 pin CPLD for v2 board
2011-09-07 partial schematic connections
2011-09-12 LPC update and gerbers
2011-09-12 xtide v1b final gerbers
2011-09-14 Continued wiring on v2: -all VCCINT connected to 3V3 -all VCCIO connected to VCC(5V) -all VSSINT and VSSIO connected to GND -used SMD rnetwork -placed decoupling caps on CPLD pwr
2011-09-25 USB stack interrupt fixes
2011-09-25 Started implementing the new AUX pins on the BPv4 in the "Power supply voltage report" with the new pinout.
2011-09-26 continue routing: removed address decoding chip, route all address lines to CPLD, address switch to CPLD, removed A18 and A19 pull ups.
2011-09-27 moved CPLD connection of DIP switches, removed R6 and JP4, connect CSEL to ground.
2011-10-02 continue routing, added resistor for external HDD LED indicator.
2011-10-05 connect CPLD vccio to 3.3v, move C2 and R2 away from ROM to provide space, put ground vias on various places.
2011-10-06 fixed JP1 and JP2 labels, added ground vias near CPLD ground pin and decoupling cap grounds
2011-10-07 18F4550 is added to the devices list for Pirate Prog
2011-10-13 Bus Pirate v3.5d -silk update and gerbers
    Bus Blaster v2.7
    -pin AC5 of FT2232H was connected to pin1 (GCK) of CPLD
    -swapped some connections to allow shorter traces
    [BusBlaster-2v7.brd, BusBlaster-2v7.sch]
2011-10-14 PIC24FJ256GB106 is added to PirateProg, 24FJxxGBxxx family is created but essentially the same with 24FJxxGAxxx (just in case)
2011-10-16 added new board with alternate routing of version 2, connect source of external HDD LED to VCC(5V), fix some text.
2011-10-20 Bus Blaster v3 upload
    [BusBlaster-3v0.brd, BusBlaster-3v0.sch, BusBlaster-v2.7.brd, BusBlaster-v2.7.sch]
2011-10-23 Bus Blaster v4 upload
    [BusBlasterv4.brd, BusBlasterv4.sch]
2011-10-24 Soldering Iron driver first draft
2011-10-24 Files for the version 1, 1st version pcbs to be built by seeed.
2011-10-24 Gerbers for the Version 1 Soldering Iron driver
2011-10-24 removed the text over the LCD header in the schematic "SCK and DIO must be RPx pins"
2011-10-25 slight corrections to the pcb,
2011-10-25 deleted old gerbers
2011-10-30 Merged my local copy with svn
    - added smd 7seg,
    - added header1x8,
    - added header2x4,
    - added jumperdescrip 2x2
    - added MAX14500.dev.scr
    - added pic12f508/9
    - added pic10f22x
    - added PIC24FJ256GB106
    - added several rgd leds
    - added USB2514
    - fixed several headers which had the first pin set wrong.
    - changed dfn/qfn footprint to aid handsoldering.
2011-11-09 Added the Fan module, and made the PC case modding tool folder
2011-11-14 - fixed jumper 2x2 description (silkscreen) - DP-LOGO was messed up, fixed
2011-11-15 added the MCLR diode, and the zener footprrint, also added the 3V3 pin ot the analog in jack. and reworked the jumper table
2011-11-17 small updates on the demo board v5
2011-11-17 Bus Pirate demo board v5 source by Sjaak
2011-11-17 Updates on the Demo board..
2011-11-17 bp demo board firmware update
2011-11-17 Finished up the CPLD XC95144XC board, and made gerbers, the older version was renamed V0
2011-11-17 Added XC95144 gerbers
2011-11-17 Adding demo v5a gerbers
2011-11-18 fixed the PEM/PWM silk screen error
2011-11-23 I2C support for LCD backpack
2011-11-26 TPA6138A2 headphone driver added
2011-12-09 PiratePicProg: applied patch from udif, adds write support for pic18 fuses
2011-12-10 DP Standard PCB sizes
2011-12-10 added big DP logo on the following boards
    [BusBlaster-v3a.brd, BusBlaster-v3a.sch, BusBlasterv4.brd]
2011-12-12 Replaced 1-wire with BrentBXR's public domain libraries.
2011-12-12 Updated th eanalog section to be in line with Arhis gen 3 board
2011-12-12 brent's UART autobaud added.
2011-12-14 Bunched up the components together a bit, so that it would fit the 60 x 37 mm board
2011-12-15 added standard PCB sizes:
    4.3x7
    4.9x8
    5.6x9
    6.2x10
    5x15
    5x20
    10x10
    10x15
    10x20
    15x15
    15x20
    20x20
2011-12-16 Bus pirate 4c board. 4066 changed to tssop, and components bunched up to fit the 60x30 cases
2011-12-16 Bus pirate 3.5d updated to fit the 60x37 case, it is aligned to perfectly fit BP4c.
2011-12-16 Disabled reset from software; instead a message to use the reset button. I also had to remove this from the '?' to allow room for the new e options. (moved around a bit to fit nicely. BXR
2011-12-17 Made two translation packages; one for v3 and below and one for v4. this update is to make it automatic. The correct translation files will be selected by using the correct MCP project and uncommenti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
    Added a version selection in base.h for the current hardware to select the correct h file
2011-12-17 Per Ians request. I removed the color coding on the 'v' command. From 10. (YL) to simply Pin 10 eg: Pin 12 Pin 11 GND 5.0V P P GND 0.00V ==BXR
2011-12-17 Changed the 'v' colors to a differnt id again. The 'Pin 10' looked bad. Now its just '#10' and looks much better: #12 #11 #10 GND 5.0V 3.3V P P P GND 0.00V 0.00V ==BrentBXR
2011-12-17 Made the static text in the uartGetbaud into the BPMSG (in both v3 and b4 and compiled both versions to work properly)
2011-12-17 Changed static messages in uart_getbaud function to BPMSG system. Also added the static 'no software reset on v4' to BPMSG for both v3 and v4 files.
2011-12-19 Added define functions to enable or disable write protection: // couple defines to enable and disable WP #define eeEnableWrite() BP_EE_WP=0 #define eeDisableWrite() BP_EE_WP=1 #define eeGetWP() BP_EE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
2011-12-19 I tested all these small v4 updates on the v3 and found a couple small issues in the seperate translation files. there now fixed. BXR
2011-12-19 Added 3 & 4 new macros to the v4 translation files: I2C>(0) 0.Macro menu 1.7bit address search 2.I2C sniffer 3.Connect to on-board EEPROM 4.Enable Writing the on-board EEPROM BXR
2011-12-19 bp demo v5 SPI update frm Sjaak
2011-12-21 AVRDude 40x speedup improvement. WARNING: uses polling of UART bits, will not work on v4 yet! Needs AVRDude patch to work: http://dangerousprototypes.com/forum/viewtopic.php?f=41&t=2629
2011-12-21 fixed BPv4 spi PPS bug
2011-12-21 Fixed v4 PPS for LCD, SPI, and UART. AUX pin still needed.
2011-12-22 Bus Pirate v3.5e and v4c: centered USB and Connector for both boards LEDs and connectors positions are same on both boards
2011-12-23 Nothing to commit. I double checked all the PPS structure and it looked fine. So I tested it and got a confirmation: FREQGEN OK PWMGEN OK SERVO OK Everything seems OK BXR
2011-12-25 Added a BP_BAUDDETECTION_ONSETUP define that enables an 11th option when setting up UART. it allows the baud to be set by detection (activity on the line needed). Also note that BP_BAUDDETECTION_ONSE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
2011-12-25 BPv4 Live Monitor UART macro glitch fix. Same stated as for v3, there is ALOT of room for improvment for this macro. but this should still work due to the USBs own buffer stack. BXR
2011-12-26 Relised the Auto Baud detection macro disabled UART but did not return UART back to an enabled state. This update should fix it. BXR
2011-12-27 I moved all the PPS related stuff into the hardware.h files. I kept the unchanged stuff commented out; once its forsure working we can delete that junk. I also found a couple more lines in SPI that n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
2011-12-28 I checked UART to ensure PPS defines work and UART worked fine. I did not test other peripherals. I also added AUX1 and AUX2 to the PPS controls for hardwarev4a.h
2011-12-28 IR Sample mode PWM frequency fix
2011-12-28 Cleanup a little bit. Added the on-board EEPROM defines (address,min,max,...). Added the only other broken out PINs PPS (why not) ADC. added 'BP_BUTTON_ISDOWN' define (so you can 'if(BP_BUTTON_ISDOWN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
2011-12-30 Added a UART macro to calculate the BRG from a BAUD rate; this was instead of allowing the user to input a BAUD upon setup. This was to test and works great; will delete this and mrge it to SETUP ins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
2012-01-04 Added documentation for the TMP006 Breakout Board
2012-01-04 more updates: moved holes' center 4mm from the corner, holes are not plated, moved push buttons of v4c moved ICSP connectors of v3.5e and v5c moved USB connectors of v3.5e and v5c
2012-01-05 Routing and labels of XTIDE-CPLD-3V3-v2 board done. Updated the pictures done
2012-01-06 -changed PCB's corner radius to 4mm
2012-01-07 -made adjustments to the labels on the board
2012-01-09 IR Toy RC5 decoder mode timer update reverted after further investigation: http://dangerousprototypes.com/forum/viewtopic.php?f=29&t=3342&view=unread#p33715
2012-01-09 uploaded useful scripts for board checking
2012-01-09 defaul unit set to mil, change default trace width to 12mil, drill size to 20. Rename remove_label_layers.scr to hide_label_layers.scr
2012-01-10 Attempt at actionitem: Offer to set baud rates when entering bridge mode. see the 6.1 development thread for details. BXR
2012-01-10 Decided there may be more macros or somthing that need to check and offer to match settings. So I moved it into a function UARTmatchSetup(). The function is enabled/disabled by the same define and BP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
2012-01-13 Added SOD-123 package for DIODE device
2012-01-15 Initial programming adapter for BPv4 schematic added, SMPS code does not block other BP functions
2012-01-16 Soldering iron Driver based on arhis Gen3 design
2012-01-17 PicProgrammer v2 schematic corrections
2012-01-17 -updated standard PCB footprints with the latest design
2012-01-18 PicProgrammer v2 schematic and code update for new pin selections.
2012-01-18 My XT-IDE ADAPTER v2 source for the most recent version of the pcb. !It's not tested, there is a small change it will work! Also updated the schematics so the unused pins on the CPLD match the net na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
2012-01-19 added pad terminal for binding post connection, the package is in 4.1mm hole diameter
2012-01-19 removed hole, just plain pad on the 4.1mm round pad package
2012-01-19 Soldering Iron Driver V1.5 based on arhis, Gen3...final files...and gerbers..
2012-01-19 PicProgrammer v2 board layout added
2012-01-19 Updated standard PCB footprints and added new PCB footprints
2012-01-19 Added new PCB DP LOGO ART footprints
2012-01-26 Minor routing change and silkscreen for pin functionalities
2012-01-27 added library for DP standard PCB sizes
2012-01-30 Updated values in schematic and some minor label touchups
2012-02-02 redesign PCB symbol, added keepout on the DP6037 pcb
2012-02-06 Adding a few SketchUp 3D models (through hole crystals).
2012-02-06 Part Ninja, v1, board, schematic and gerbers
2012-02-06 updated DP6037 standard PCB footprint
2012-02-06 Added 90 degree ATX 20 pin power connector
2012-02-07 Adding a few SketchUp 3D models (Female pinheaded connectors 1x1 to 1x20).
2012-02-08 BPv3 lcd adapters on standard pcbs...along with gerbers
2012-02-08 BP4 LCD adapter V4 on a standard case, along with gerbers
2012-02-08 Bus Pirate V3 and V4 programing adapter files, (1 and 2 moved to standard pcbs...along with gerbers
2012-02-08 fix 4.1mm round pad, turned on the solder mask "stop" on the pad's property
2012-02-09 Add: DPDT push button switch, 90 degree mounted 5mm LED, 2x2 PTH header, 1x4 PTH header
2012-02-09 implemented keepouts and centerlines on default PCBs. PCBs who's exceed the limit on Eagle Lite are excluded on these implementation. Implemented by Filip.
2012-02-09 added webplatform v1.2. webplatform in standard DP PCB.
2012-02-09 fixed DP10062_V1. removed duplicated holes that gives an error in DRC
2012-02-09 updated DP10062 PCB package
2012-02-13 Added new board for XTIDE CPLD 3V3 v2a with labels for credits on peitja, J1mbo, alanh and for the Vintage Computer Forums
2012-02-13 Added gerber for the XTIDE-CPLD-3V3-v2a board
2012-02-13 updates: added DP logo on top silk, CC-0 and OSHW logo at the back, fix power select text to USB and EXT for USB and External power, added label for 6-9V external supply, change version to v1a, moved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
2012-02-13 XT-IDE ADAPTER v2 source with "Chuck mod" also adding CPLD logic schematics
2012-02-14 updated bus pirate v3.5e board.
2012-02-14 revered to Jer's 1658 PCBs
2012-02-14 added: - 5050 rgb led - SO-8 package for PIC12(L)F1822
    changed:
    - added pin1 indicator for so-8 package
    - fixed silkscreen for so-8
2012-02-15 updated v3.5 and v4 board to the new DP6037 standard PCB
2012-02-15 updated v4 board. Fixed SWV33 trace that trespass on the mounting hole's keepout. gerber files created
2012-02-16 updated BP accessories: HV programming adapter for bus pirate V3 and V4 Made the female IO header location fixed with the Bus Pirate IO header 8.5mm from board edge in x axis.
2012-02-16 removed old gerber for BP V4 LCD adapter
2012-02-16 USBIRtoy.v3 board fitted on the new DP6037 PCB
2012-02-16 updated v1.2 board, moved CC-BY-SA license and OSHW logo to bottom. Made gerber files
2012-02-17 Bus Pirate v4c minor revisions External power header location is now @ (3 27) in mm. Fixed the two out of grid vias mentioned to (1 29), (8 36) in mm. Make all vias drill uniform: 20mil - signal and 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
    Bus Pirate v3.5e SSOP minor revision
    Make all vias drill uniform: 20mil - signal and grounds, 30mil for power traces
    Updated gerbers
2012-02-17 Added BusBlaster-v3.5 board in a standard DP8049 PCB.
    [BusBlaster-v3.5.brd, BusBlaster-v3.5.sch]
2012-02-17 uploaded gerber for BusBlaster-v3.5
2012-02-20 updated gerber for Bus Pirate LCD adapter v3.
2012-02-20 Updated USBPOVToy.v1c board, added logo on the bottom pcb.
2012-02-27 Micro constant Current from SQKYbeaver
2012-02-29 PIC32DIP Breakout Board gerber and Eagle Files
2012-02-29 PIC32DIP *cleaned up the schematic, added the DPexport output (BOM, and PNG images)
2012-02-29 PIC32DIP, made some BOM shanges (adjusted the Cap values
2012-03-01 Gerbers and Eagle files for the PIC18F2550 and PIC24FJ64A_B002 breakout boards
2012-03-07 Updated to the valuse of discrete components on the schematic for Part Ninja
2012-03-07 Updates tot he pic18f2550 schematic, and export files
2012-03-08 Updated board for PIC32DIP -Rotate Reset button, so the 3.3V trace will not cross the USB signal below. -Make most label sizes to 50 mil 12% ratio -Make crystal pad (annular ring) larger 1.6 mm dia -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
2012-03-10 BOM .wik file for the pic24 and pic32 breakout SOIC28
2012-03-10 Updated the pic24 and pic32 coic28 BB schematic Values
2012-03-12 updated board, widen up spaces for ease of soldering, added OSHW and CC-0 Logos.
2012-03-12 updated board, widen up spaces, add CC-0 and OSHW logos.
2012-03-12 change version to V1a, board is now consistent on version 1771 schematic.
2012-03-12 updated version to V1a, board is now consistent with schematic in revision 1768
2012-03-12 Change version to V1a Breakout pin 23 and add Soldering jumper going to 3.3V in case USB mode is used.
2012-03-13 Various DP conferences materials
2012-03-13 Dangerous Prototypes conference materials
2012-03-14 Modification to the Sketchup 3d Models. Some parts were duplicated to match the names with the library. USB connector from [Squonk]. Guide lines on some parts were deleted. Backup files deleted.
2012-03-14 Reverted v1's gerber and images. Added v1a gerber and images too.
2012-03-14 revert v1's gerber and schematic image. Added v1a gerber and brd and schematic images.
2012-03-14 reverted v1 board and schematic image and gerber. Added v1a board and schematic image and gerber
2012-03-26 Bus Pirate v3 Blink MODE LED demo firmware
2012-03-27 updated v1a board to v1b, widen PIC and Reset Pads for easy soldering
2012-03-28 Demo Mode LED blinking demo for the Bus pirate, zipped up project files
2012-03-28 updates to the BP demo blink led
2012-03-28 blink LED BP demo update
2012-03-29 update DP eagle library, added ATMEGA32U4, MAX6921. updated the SOIC-28W package to have a larger pads, updated small tactile switch footprint to have a larger pads too. fix center of VFD IV 22 displ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
2012-03-29 updated Bus Blaster v4.0 board. Fix connection between FT2232 1.8V output to CPLD 1.8V supply pins
    [BusBlasterv4.brd, BusBlasterv4.sch]
2012-04-12 Added: ENC28J60, HC49U PTH crystal, 2MM DC barrel jack PTH version, Coil inductor L1812. updated eagle library.
2012-04-12 PiratePICProg: Commited patches from AndThen (PIC32MX), PIC32 still needs work. Added verbose debugging print (so far buspirate and serial module). Fixed PIC24 readout support, fixed endiannes of rea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
2012-04-24 Bus Pirate UART demo
2012-04-24 renamed bus blaster v3 and v2.7 to match conventions
    [BusBlaster-v2.7.brd, BusBlaster-v2.7.sch, BusBlaster-v3.brd, BusBlaster-v3.sch]
2012-04-24 updated BP demo board v5b to be in a standard DP PCB (DP6037)
2012-04-25 UART demo RAR->ZIP
2012-04-26 uploaded ATX-PSU eagle board files
2012-04-26 Standard PCB footprints
2012-04-26 Add Standard DP PCB eagle library
2012-04-26 standard PCB art update
2012-04-27 Added: USB micro-b, LTC4053, removed eagle lite unsopported DP PCB sizes from dp_pcb.lbr
2012-04-30 updated Bus Pirate v3.6. In Standard DP6037 PCB, version labels updated to v3.6
2012-05-01 Bus Pirate on standard PCB format.
2012-05-01 moved Bus Pirate board files to folders
2012-05-01 BP LCD adapter BOM
2012-05-02 renameing and small value changes to Bus Blaster v3.5, now V3b. also added new gerbers, partlist, and quote package. v3,5 removed
    [BusBlaster-v3.5.brd, BusBlaster-v3.5.sch, BusBlaster-v3b-partlist.xls, BusBlaster-v3b.brd, BusBlaster-v3b.sch]
2012-05-02 Missing Bus Blaster v2 buffer with self test. It should have been here...
    [jtagkey_test.v]
2012-05-09 Added the Bus Pirate ADC demo project files,and archive
2012-05-10 0g Calibration implementation
2012-05-14 Added PEC12 model Incremental Encoder with switch. added pin marker on SSOP-20 footprint
2012-05-16 Fix UART transparent mode for BPv4 and allow exit from tranparent mode with Normal button
2012-05-18 Added: 2x07 shrouded pin header
2012-05-24 removed base to collector resistor on T5, add base to emitter 10k resistor on T5, change value of resistors R16, R18, R19 to 10k, change value of resistor R15 to 1k, update trimmer to new footprint, 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
2012-05-24 upload image of schematic and board. upload gerber for v1c
2012-05-25 Added: FT230X, fix footprint of Tact switch and trimmer
2012-05-25 commit SSOP-16 footprint and updated FT230X part
2012-05-25 Part Ninja, firmware update: rehaul of the checkConduct function insted of using 5V---[r680]--ADC--[A][B]---GND....
    it's now 5V--[A][B]---[ADC]---[R680]----GND...
2012-05-28 Added: LM317 TO-220 vertical under VREG_3PINS_ADJ-* device. Renamed IC_VREG_3PINS devices to VREG_3PINS. Renamed IC_VREG_5PINS device to VREG_5PINS
2012-05-28 Part Ninja firmware updates: capacitor measurment testCap function (test.c) implemented through comparator interrupt in main.c
2012-05-28 Part Ninja Firmware updates.... Capacitanc and Resistance measurmetn deslpay with proper units...addad
2012-05-28 Part Ninja firmware:
    made updates to testCap function in test.c,
    it now brings the untested 3rd bin low, to keep it from accidentally causing a comparator interrupt, if the unused comparator is connected to it...
2012-05-30 Fix FT230X SSOP-16 footprint, added SSOP-16-FTDI footprint
2012-06-01 Added: LM337 voltage regulator. Add DO-214AC footprint in DIODE
2012-06-04 small changes to the processing app, added sugest part Button
2012-06-07 fix 2x05 and 2x07 shrouded pin header. made the silk a little larger to fit on actual header
2012-06-12 bus pirate binmode SPI speed fix from: http://dangerousprototypes.com/forum/viewtopic.php?f=40&t=3864#p38949
2012-06-12 bus blaster v4 buffer removed commented pin numbers.
2012-06-15 USB echo demo ported to the PIC18F2550 Breakout Board
2012-06-15 PIC24FJGB002 Breakou Board USB echo demo ported
2012-06-25 Added devices: 74HC4017 (TSSOP16), 74HC595(TSSOP16), ULN2003(TSSOP16) and 555 (SOIC8)
2012-06-27 USB descriptor and PID fix ( http://dangerousprototypes.com/track/view.php?id=39 bug fix)
2012-06-29 Device identification AVRISP_2 changed to STK500_2 to make it work with AVR STUDIO 5 and above .
    In avrdude, set programmer as STK500V2 .
2012-07-04 Added a credit card sized to the standard rectangular PCBs
2012-07-10 renaming scheme, and added 3d models and laser cut files for the ATXv1.1 SoB case
2012-07-13 procMenu.c : while(UART1TXRdy == 0); changed to while(0 == UART1TXRdy());
2012-07-13 baseIO.c : UART1RXRdy() define is converted to function to be consistent with BPv4. This also fixes compilation error in BPv3 due to changes in previous revision.
    Workspaces, translation etc.. : File names renamed with BPv3 and BPv4 prefixes consistency.
2012-07-13 update board to v1d, fix "Fulfillment" spelling
2012-07-17 Bus Pirate SOB case
2012-07-17 added dimmentions to the templates, for easier laser cutting gude..
2012-07-19 Commit Bus Blaster v4.1 brd, a Bus Blaster v4 fitted to Standard DP9056 PCB
    [BusBlasterv4.1.brd, BusBlasterv4.1.sch]
2012-07-23 updated v3 and v4 shrouded header with the correct silk, fix v4 "Fufillment" mispelling. Please use latest v3c and v4.1a
    [BusBlaster-v3c.brd, BusBlaster-v3c.sch, BusBlasterv4.1a.brd, BusBlasterv4.1a.sch]
2012-07-24 Added parts: KSZ8851SNL, TPS6120X, 2X08 HEADER, 3x6 mm 2pins switch, 1.8" TFT LCD Added 2x10 Shrouded Pin Header variant to existing 2x10 Header
2012-07-25 Bus Blaster v3 svg files, and BoM
2012-07-25 Exploaded sob case assemplby 3d model
2012-07-25 Update for BP v4 Passive LCD adapter v1a -renamed to BPv4LCDadapter v1b -added 74HC595 serial to parallel -removed polarity jumpers? (2x03) of LCD backlight -added control transistor of the backlight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
2012-08-03 Parts Added: 3.3v, 5v, vusb, gnd supply symbols, 2 and 3 pins wire to board screw terminal block, USB AF SMD. Parts updated: 2 and 3 pins jumper description change layer to tDocu.
2012-08-14 Changes to USB interrupt from JTR
2012-08-14 Added USB interrupt fix to BPv4 from: http://dangerousprototypes.com/forum/viewtopic.php?f=28&t=3441&start=45#p42038
2012-08-14 UART inverse transmit pin was omitted in all BP versions:
    http://dangerousprototypes.com/track/view.php?id=47
2012-08-16 Bus Pirate Demo board firmware
2012-08-20 Added device: 23LC1024 SRAM in SOIC-8
2012-08-23 Nixie display driver
2012-08-27 update to blog theme with header fix, switch for contest theme.
2012-08-27 update ATX PSU v1.2: expanded ATX Connector drill pads from 1.4mm to 1.7mm, "Fulfillment" spelling fixed
2012-09-04 Added devices: 74HC595 and 74141 Added footprint: DIL16 Updated: removed extra mounting holes on DP6060 Added schematic symbol: 12V, -12V and -5V Added Logo: Flame logo
2012-09-04 revised credit card sized PCB based on ISO.IEC 7810 ID-1 identification cards sizes, size changed from 85 x 56 mm to 85.60 x 53.98 mm
2012-09-04 update Standard rectangular PCBs devices
2012-09-05 SU originals for the ATX case laser cutting
2012-09-06 little file reshuffeling in the ATX laser cutt files
2012-09-07 Fix IN-12 socket, replaced with correct cutout.
2012-09-07 Added: IN-12 Nixie tube display, IN-12 Socket cutout footprint Fixed: IN-12 Socket
2012-09-12 Updated ATX PSU v1.3 Added ATX PSU v2 board. Board was made in KiCAD
2012-09-12 first commit of DP KiCAD part library
2012-09-12 DP KiCAD parts
2012-09-13 .lib and .mod files converted using eagle2kicad-0.d.ulp from http://www.modulbot.com/download.html Fixed undefined DRAW command when loading to symbol library to KiCAD
2012-09-17 add bus pirate v5c board, enlarge ADC Input label
2012-09-19 Added: INA138 device
2012-09-20 Bus Pirate v4 Sick of Beige case laser cutting files and partlist(BOM)
2012-09-21 SoB case generator plugin from Tayken
2012-09-25 Board files
2012-09-25 add schematic image
2012-09-26 swapped drain and source pin of the p-mosfet controlling fuse blown switch
2012-10-02 Added MIC2027, D8035E VFD and update Arduino outline header placement outline
2012-10-07 Adding a vertical ATX socket from the Molex MiniFit Jr. line.
    Discrete sockets (key'ed and rectangular) are provided in separate files so they can be easily added to create different configurations. Each socket is made to be "stackable" on both sides, so you'll wind up with the proper pitch just by connecting corners - stacking until you get the desired number of positions.
2012-10-08 Added: TD62783 8 Ch high side voltage source driver Updated: 74595 shift register symbol, changed pin names of SCLK, SDA, LATCH and RST
2012-10-08 Added: D8035E VFD board, composed of 3 boards. Board A, B and C
2012-10-08 Added: PTH variant of 2.1mm DC Barrel Connector with milled hole pads
2012-10-08 VFD Board, render and 3D model..
2012-10-09 added series diode on Vusb in and Vin header, moved C8 beside SD holder
2012-10-10 first cut at molex KK series connectors. The 1x2 should be modeled in such a way that it's side stackable, so it will be easy to make additional even numbered connectors. These were based on a model 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
    These should be "close enough" for most purposes, alignment appears to be off a bit on the 4pos header though.
2012-10-10 ATO fuse clip, ATO fuse holder, and ATO jumper. Created from a minimal datasheet from Littlefuse 01000057Z.
    Can be found at Mouser:
    http://www.mouser.com/ProductDetail/Littelfuse/01000057Z/?qs=sGAEpiMZZMtN62bhLohzxVzkiLrmT5C%2f
    Other alternatives for high current voltage selection were discussed here:
    http://dangerousprototypes.com/forum/viewtopic.php?f=56&t=4509
2012-10-10 Bourns TC33X-2-104E 3mm surface mount trim pot
2012-10-10 Added: 3D models for 2 trough-hole IC and a metalized Capacitor.
2012-10-18 adding some 3.5mm side stacking screw terminals. The model is based on a phoenix 1984617, but should be representative of most side-stacking 3.5mm screw terminals.
    An individual component is also included, which should makes it really easy to quickly generate any number of positions (just do a move/copy, explode the components, and erase the lines along the seams).
2012-10-18 correcting the naming for the 2512 resistor model
2012-10-18 adding a 2010 resistor
2012-10-18 Added device: MicrosSD fold type socket, PIC24F16KA102, 1x2 SMD solder jumper. fix Arduino 1x8 header containing pin 8 - 13, offset ed location.
2012-10-22 Soldering Iron Driver renderings and 3D model
2012-10-25 Add project: FT311 breakout board v1b
2012-10-28 Retrieved demo board v5 files from previous revision, and renamed the wrongly named v5a into proper names
2012-10-30 added: 1x08 and 1x06 0.1 pitch SMD female header
2012-10-30 added DIL-28 PTH to SMD socket
2012-10-31 Added manufacturing files for updated ATX board acrylic case
2012-11-05 added: standard right angled tactile switch
2012-11-07 added right angled 0.1inch 1x06 male header. expanded M1X4, M1X6, M1X8 pads to 1.632mm and drill size to 1.02mm
2012-11-15 add 0.50mm, 0.65mm and 0.80mm xQFP V1 protoboards
2012-11-19 BP v4d, buspirate v4 fitted into a bigger DP PCB (DP7043)
2012-11-22 added ICSP with pogo pin as connector
2012-11-22 added v2.1, LCD_Backpack_1.8_TFT with pogo footprint ICSP
2012-11-22 fix, ICSP pogo pin programmer footprint by adding a pad on the keyhole for a key pogo pin to be soldered
2012-11-30 added 0.50, 0.65 and 0.80 mm pitch universal QFP footprint and QFP breakout board These footprint are licensed: CC-BY-SA
2012-12-06 added protoboard with 0.50mm xQFP
2012-12-06 added protoboard with 0.65mm and 0.80mm xQFP
2012-12-07 added BP v4e, fix odd angled placement, no 45 degrees placement anymore. replaced ICSP header with miniature ICSP footprint
2012-12-07 updated 0.5, 0.65 and 0.8 xQFP protoboards by adding a USB footprint. 2-3 SOT-23-6 footprints were removed to fit the usb
2012-12-10 added a 6 way SOLO stacker connector and footprint
2012-12-12 added dual xQFP pitch protoboards, pitch combined are 0.50 + 0.65 mm, 0.80 + 0.50 mm and 0.80 + 0.65 mm. these boards were also having a micro usb footprint under its mini-b footprint
2012-12-12 adding dual pitch back to back footprint on xQFP breakout, combined pitch are 0.50 + 0.65, 0.80 + 0.50 and 0.80 + 0.65 mm QFP
2012-12-12 added TSSOP-20 variant of TXB0108, voltage level translator
2012-12-14 fix pad, changed via to a pad. new board named v1b
2012-12-20 added: 1x1 PTH hole for protoboard filler changed "board name" of DP standard PCB name(on the bottom) to ">NAME" so it will now be smashable a can be moved around.
2012-12-20 revert back DP Standard PCB with the label name indicating its PCB size
2012-12-20 made DP PCB label name to an attribute type, the label can now be smash and moved.
2013-01-07 added 0603 SMD LED, 1x02 and 1x03 right angled 0.1 inch pitched PTH header
2013-01-09 Patches applied for Bus Pirate Tracker isues 66 and 73 http://dangerousprototypes.com/track/view.php?id=66 http://dangerousprototypes.com/track/view.php?id=73
    66: bpWlongdecf() fails to correctly print out some values
    73: Improving Frequency Measurement Resolution & Gremlins
    patch 66 baseIO.c bpWlongdecf() function tested, and working.
    Patch 73 untested, but compiles and doesn't break any of the functions.
2013-01-10 Bus Pirate - AUXpin.c. Cleaned the code a bit, deleted a huge commented out section, and applyed the patch in issue #65 http://dangerousprototypes.com/track/view.php?id=65
2013-01-11 Bus Pirate firmware -v4 pull up voltage control add to bin protocol. as per issue 63 http://dangerousprototypes.com/track/view.php?id=63 patch available at the link above, and is applied to rev2082
2013-01-11 Bus Pirate firmware - the issue 50 solution. r (reads) are now posible to switch the display modes on the fly with simple d,b,x comands.. rd,rx,rb brind DEC, BIN, and HEX respectfully
2013-01-14 A slight change in variable definition in procMenu.c, and indent fix in I2C.c
2013-01-16 Bus Pirate firmware issue 51 minor fix to the protos function pointer array, in the BP_USE_I2C section. nulfunc changed to I2Cstop.. http://dangerousprototypes.com/track/view.php?id=51
2013-01-17 Bus Pirate firmware version change to v6.3 + Issues 57 and 24 ...
    Version change to 6.3 - We're clearing out the backlog of issues so it's a perfect time for a version change to 6.3
    issue 57
    http://dangerousprototypes.com/track/view.php?id=57
    a clutch is added between the setup process and the start of using a protocol, Once setup is done all the pins are still at HiZ. only when you type in the 'W' commend does the clutch engage - pins are actualy connected to peripherals...
    issue 24
    http://dangerousprototypes.com/track/view.php?id=24
    Since the PPS peripherals ignore the TRIS bits, seting or clearing of TRIS bits was never implemented, so the 'v' commmand readss outputs as inputs. I added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
2013-01-25 Added PTH 2x7 0.1" header, fix TSSOP-20 footprint pad arrangement, fix 74AC573 TSSOP-20 pin numbering
2013-01-25 * Added Gerber files.
2013-01-27 * Added color scheme for logic shrimp probe cables.
2013-01-28 Bus Pirate Firmware - issue 53. Basic scripting engine put back into v6.2.... http://dangerousprototypes.com/track/view.php?id=53
2013-01-31 Bus Pirate Firmware issue #89 - adding UART communications in debugging mode, to activate, #define BPV4_DEBUG, to deactivate comment it out in base.h.. This lets you to connect your debugger and run 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
2013-02-01 update v3c and v4.1a, change value of R8 to 0R and RN1 and RN2 to 82R, unpopulate D1 on BB v3c, change value of R7 to 0R and unpopulate D1 on BB v4.1a. added final v3c and v4.1a to package folder
    [BusBlaster-v3c-partlist.xls, BusBlaster-v3c.brd, BusBlaster-v3c.sch, BusBlaster-v4.1a-partslist.xls, BusBlasterv4.1a.brd, BusBlasterv4.1a.sch]
2013-02-11 fix ICSP 0.1 inch header pin 5 made it to a circular pad. added proto pads with 1.2mm diameter drills
2013-02-14 * Increased the offset for the ICSP holes from 2 to 4 mils.
2013-02-18 add: PTH ferrite bead 10mm pitch, 20x20mm 8x8 LED matrix
2013-02-19 Mark pin 1 of DIP8, DIP14, DIP14W as this is automatically changed to a square pad by DRC check. Corrected SO-8's name and values labels to their proper layers
2013-02-19 Bus blaster v3 manufacturing test package
    [BusBlaster-v3c-partlist.xls, BusBlaster-v3c.brd, BusBlaster-v3c.sch]
2013-02-19 update parts list of v3c and v4.1a, copied updated parts list to /hardware folder, made manufacturing resources files for v4.1.
    [BusBlaster-v3c-partlist.xls, BusBlaster-v4.1a-partslist.xls, BusBlasterv4.1a.brd, BusBlasterv4.1a.sch]
2013-02-21 add BP v3.8 I/O arrangement changed to 5V - GND VPU - 3V3 AUX - ADC MISO - CS MOSI - CLK
2013-03-07 updates on v3.8 USB connector now in micro-B All SMD LEDs are in LED603 IO shrouded header fix, notch is facing outward not much change on the USB D+ D- line just did route them to have almost the sa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
2013-03-11 Added single pad with 40mil and 32 mil drill size both square and round Added SOIC 14W, 18W, 8NW, 14NW and 16NW footprints N-narrow, W-wide, NW - Narrow + Wide Added 10cm x 10cm (DP100100) in SoB
2013-03-13 change U3 of parts list from a 44 pin to 100 pin XC2C64A-7VQG100C CPLD
    [BusBlaster-v4.1a-partslist.xls]
2013-03-14 I know the SPI module works with the changes made to the underlying communication tools. However, all the other modules need some verification. I'll probably try to put together some unit-tests. Howe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
2013-04-03 Added: MCP4131 Digital Potentiometer Tester Probe socket QFN 12 and 16 pins 3x3cm QFN 16, 20 and 24 4x4 cm SOIC Narrow+Wide 18, 20, 24 and 28 pins
2013-04-16 Initial Folder for Test Probe Adapter
2013-04-16 Added board files
2013-05-08 moved anchor/reference point of SoB PCBs to its center
2013-07-09 Bus Pirate - applied patch for AVR DUDE, tracker 113 http://dangerousprototypes.com/track/view.php?id=113 compiled to version bp6.3r2151, added hex files
2013-07-23 Added: MCP7940 I2C RTC with SRAM in SOIC8 and DIP8, Alternate 3 Pins Voltage Regulator to accomodate 4th pin as tab connection. Revised VREG 3 PINS now with TO-220 Horizontal footprint
2013-07-24 bus pirate: fix slashes and filename case for linux compatibility
2014-01-10 changed SMD SMC-A pad size from 1.60 x 1.40 to 1.40 x 1.80 changed SMD SMC-B pad size from 1.60 x 2.40 to 1.40 x 2.80 added new SMD SMC-C footprint added part MBI5026 (SOIC-24 variant) 16-Bit constan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
2014-02-03 Stepper motor driver based on Linistepper v2.0 (http://www.romanblack.com/lini.htm)
2014-02-23 SPI mode } command was giving errors, busPirateCore.c line 225 now maps to SPIstop for stopR. Should fix it. Untested.
2014-03-21 correct EEPROM for v2/2.5, v3c and v4a, old EEPROM value was non 3.3V compliant (93C46), replaced with 93LC46B. updated schematic, wiki, BOM/Partlist. Board and gerbers still the same
    [BusBlaster-v2.0a1.brd, BusBlaster-v2.0a1.sch, BusBlaster-v2.5-partlist.xls, BusBlaster-v2.5.brd, BusBlaster-v2.5.sch, BusBlaster-v2a1-partlist.xls, BusBlaster-v3c-partlist.xls, BusBlaster-v3c.brd]
